holla2040/hyatt/README.md

# hyatt
A CNC wood router based on OpenBuilds WorkBee 1010, [Cypress PSoC 5LP CY8CKIT-059](http://www.cypress.com/documentation/development-kitsboards/cy8ckit-059-psoc-5lp-prototyping-kit-onboard-programmer-and) and [PSoC GRBL](https://github.com/bdring/Grbl_USB_Native). 

Hyatt Feature Set
* CY8KIT-059 based design
* 4 axis CNC controller, Dring GRBL port - PSoC HW pulse generation, debounce, interrupts
* Spindle speed/direction control - PSoC PWM
* Piezo element work piece probe - PSoC opamp, ADC, DAC comparator, interrupt
* Motor drive current monitor - PSoC analog mux and ADC
* Supply voltage monitor - PSoC ADC
* WiFi link with webserver, OTA, flash filesystem, websockets, TCP-serial bridge using ESP8266 - PSoC USART

Operator Interface
* 12 illuminated buttons via I2C I/O port expanders - PSoC I2C Fixed master
* Jog wheel with quad encoder - PSoC quad decoder
* 20x4 LCD panel display - PSoC I2C Fixed master
* 3.5" TFT 480x320 resistive touch screen display, attached to X axis gantry - PSoC USART
* Real-time feed speed override - PSoC ADC
* SDCard reader- PSoC SPI EmFile library
* Wireless CNC pendant - DirecTV remote control - my custom IR decoder using PSoC digital logic

[Hyatt Openbeam Workbee 1010 Settings](settings.txt)

PCB board, 100x100mm 2 layer, mixed through and smt parts

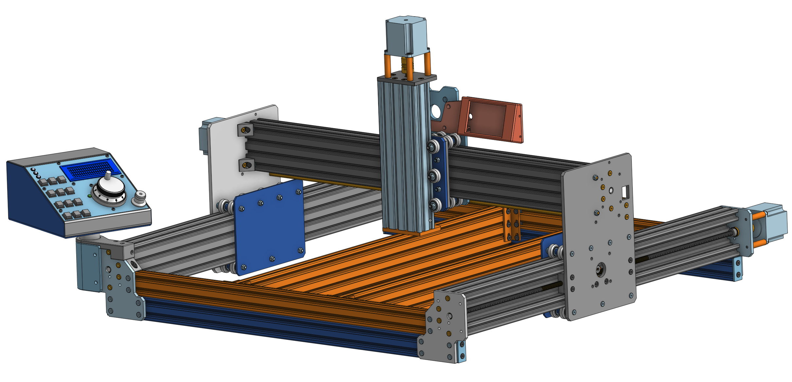
[picture p1: images/workbee-hyatt.png]
WorkBee


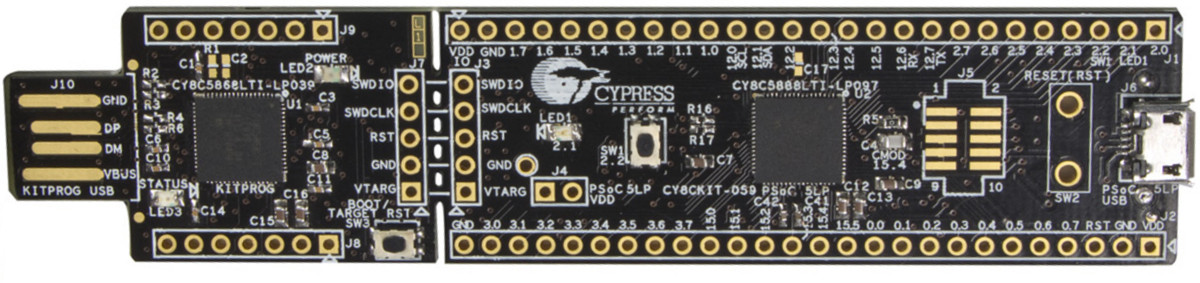
[picture p2: images/cy8ckit-059.jpg]
cy8ckit


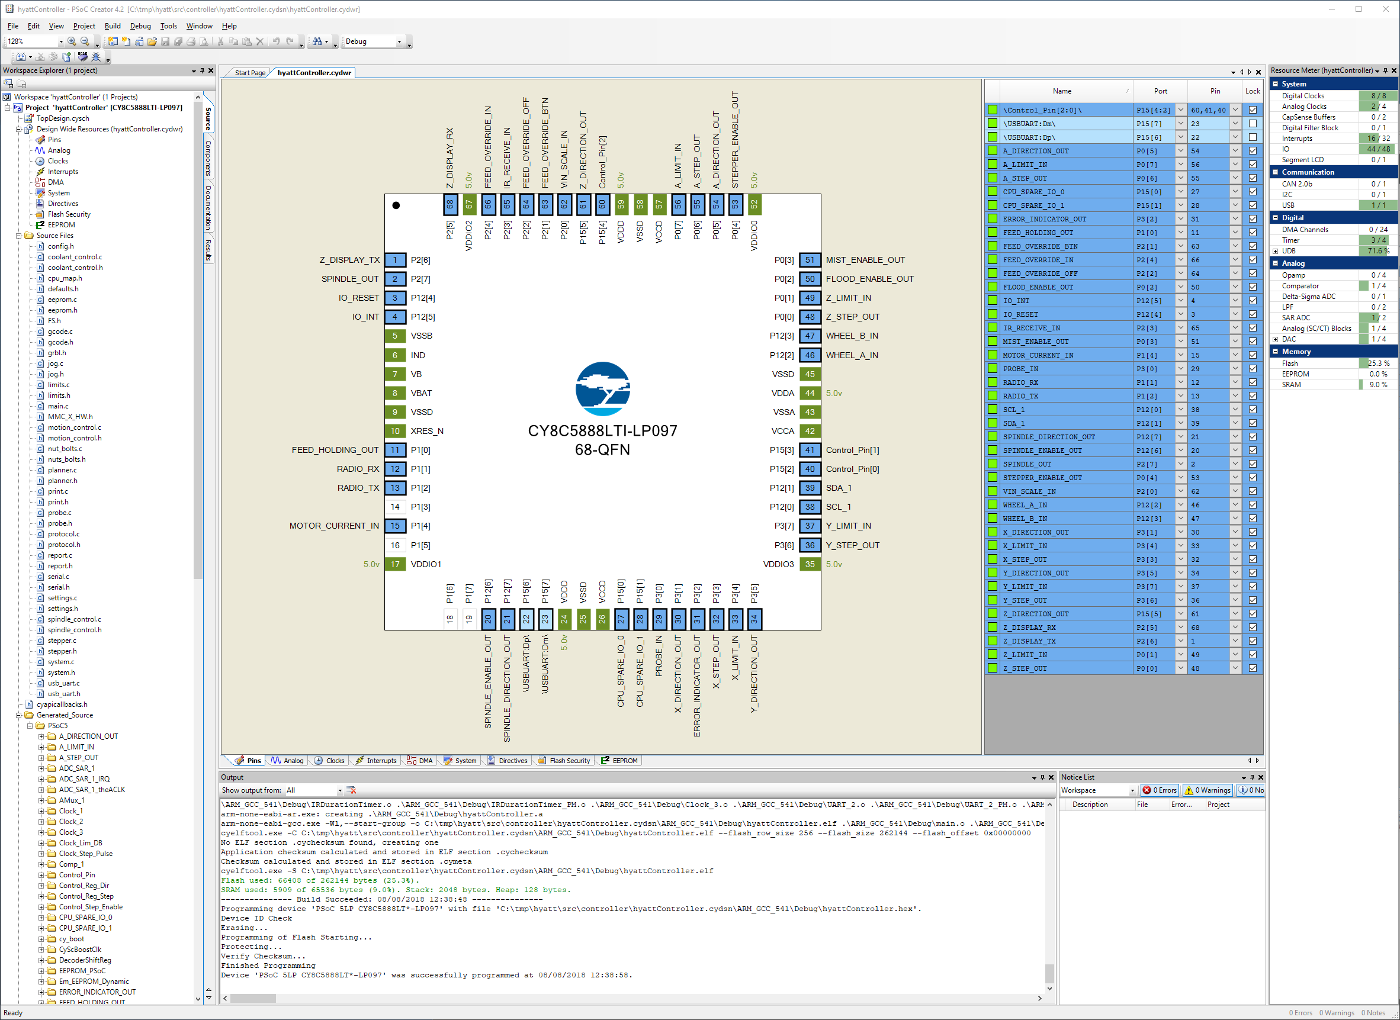
[picture p3: images/psoc5pins.png]
pins


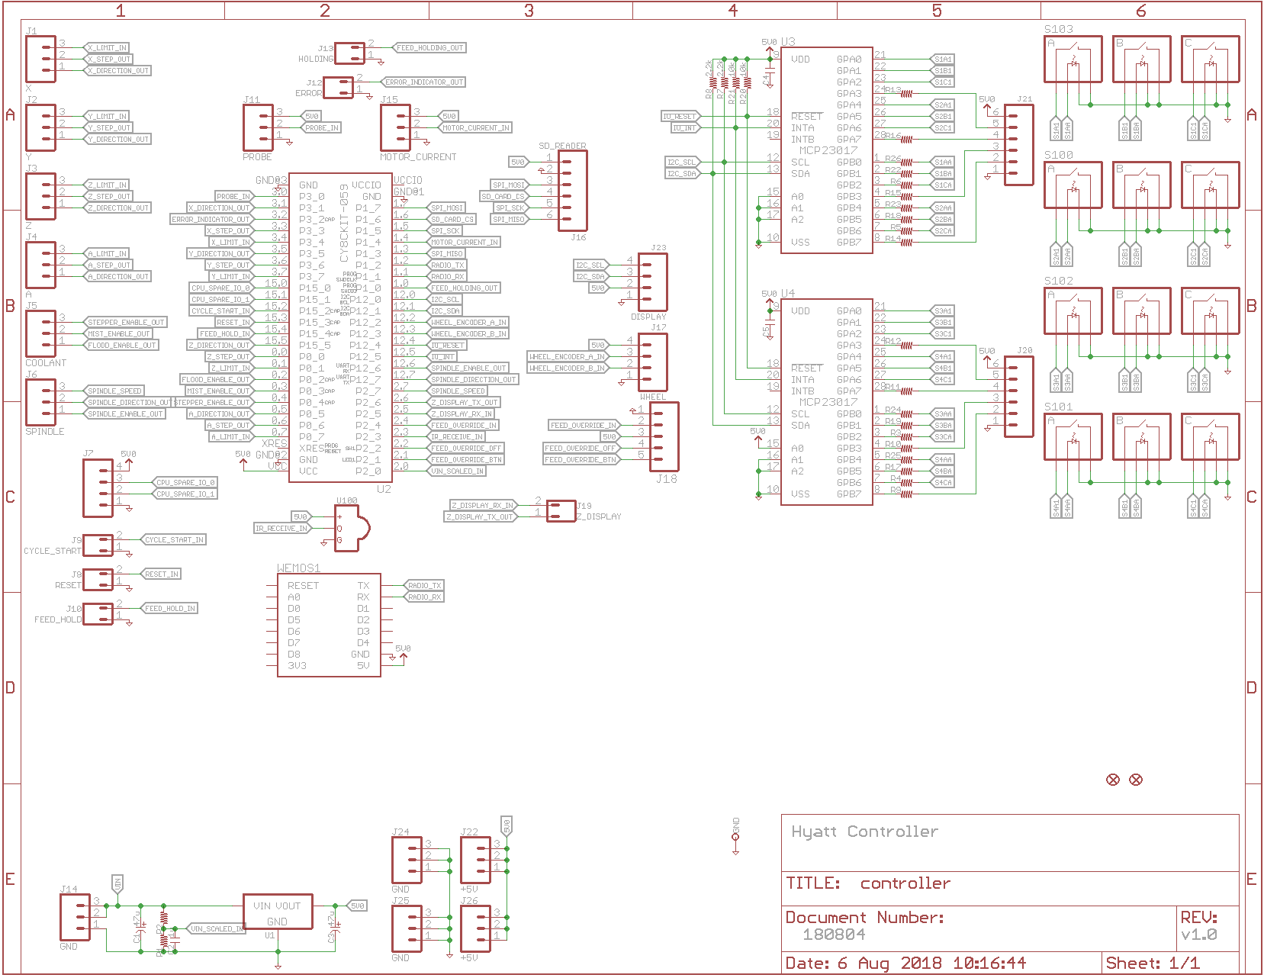
[picture p4: images/schematic.png]
schematic


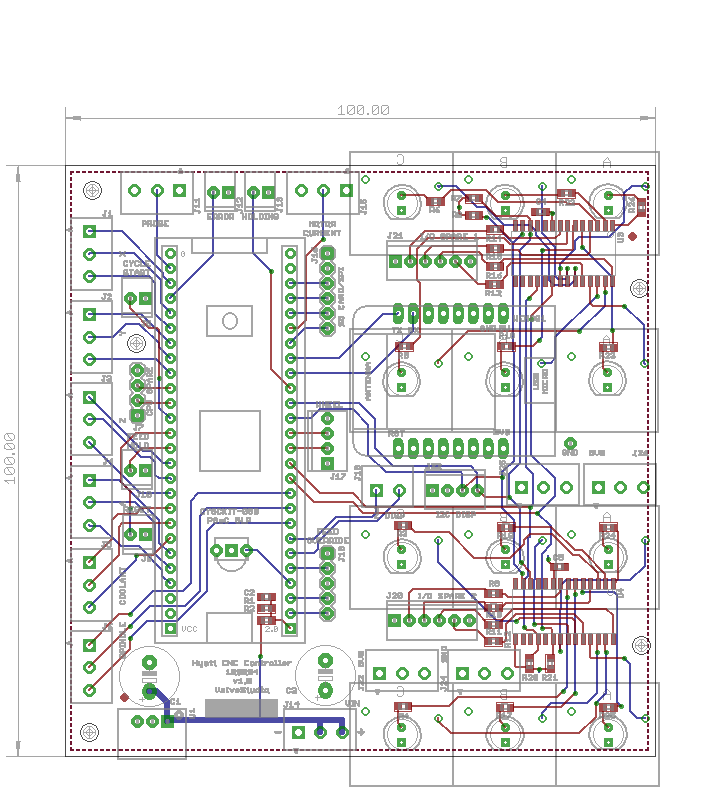
[picture p5: images/board.png]
board


---

Getting boards from [JLCPCB](https://jlcpcb.com/), $2 for 10 boards + $18 DHL US shipping.

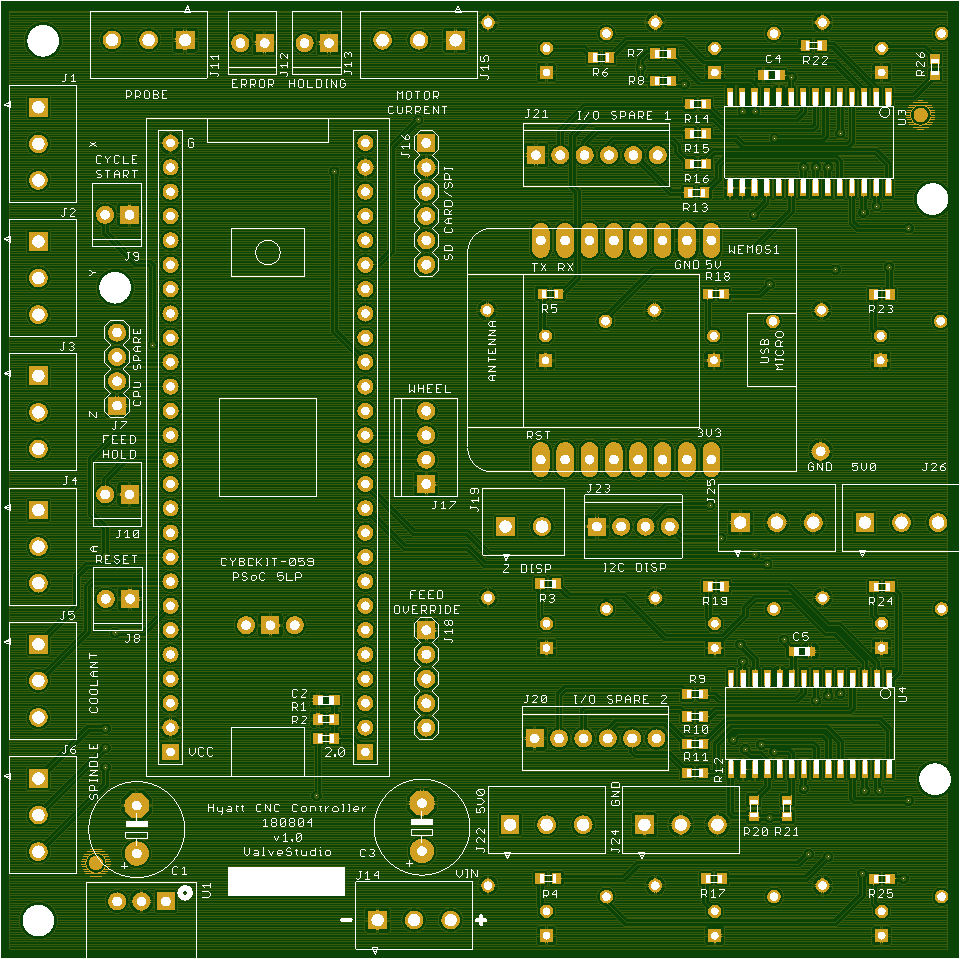
[picture p6: images/hyatt-PCB-component-v1.0-180804.png]
PCB Component Side


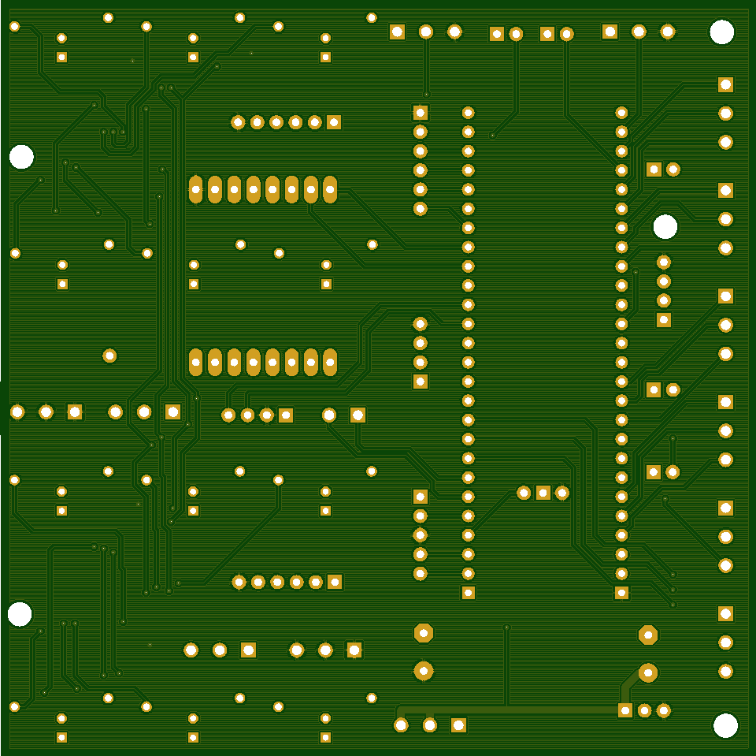
[picture p7: images/hyatt-PCB-solder-v1.0-180804.png]
PCB Solder Side


---

Watch the video (https://youtu.be/vaoxWDlP-cQ)

[Watch more hyatt videos](https://www.youtube.com/user/holla2040/search?query=hyatt)

---

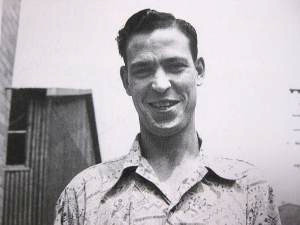
[picture p8: images/DaleHyatt.jpg]
Dale Hyatt


Project named after Dale Hyatt, the one of the original K&F guitar amp cabinet makers. See "[The Sound Heard 'Round the World](https://www.halleonardbooks.com/product/viewproduct.action?itemid=332779 "Fender - The Sound Heard 'Round the World")", Richard Smith, p28.
