holla2040/hyatt/src/controller/README.md

# hyatt controller
The hyatt controller software is based on Bart Dring's PSoC5 GRBL project, https://github.com/bdring/Grbl_USB_Native. Bart's project has GPL3 license, therefore my 'larger work' software additions also has this license.
