holla2040/hyatt/src/babysteps/cmm/centerOfCircle/circlePassingThrough3points.pdf

Circle passing through 3 points

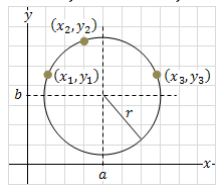
[picture p9: figure]

ambrsoft.com | Page 1 | R1.0

## AmBrSoft

–
