holla2040/hyatt/datasheets/Cypress - CY8C5888LTI-LP097.analog block.png

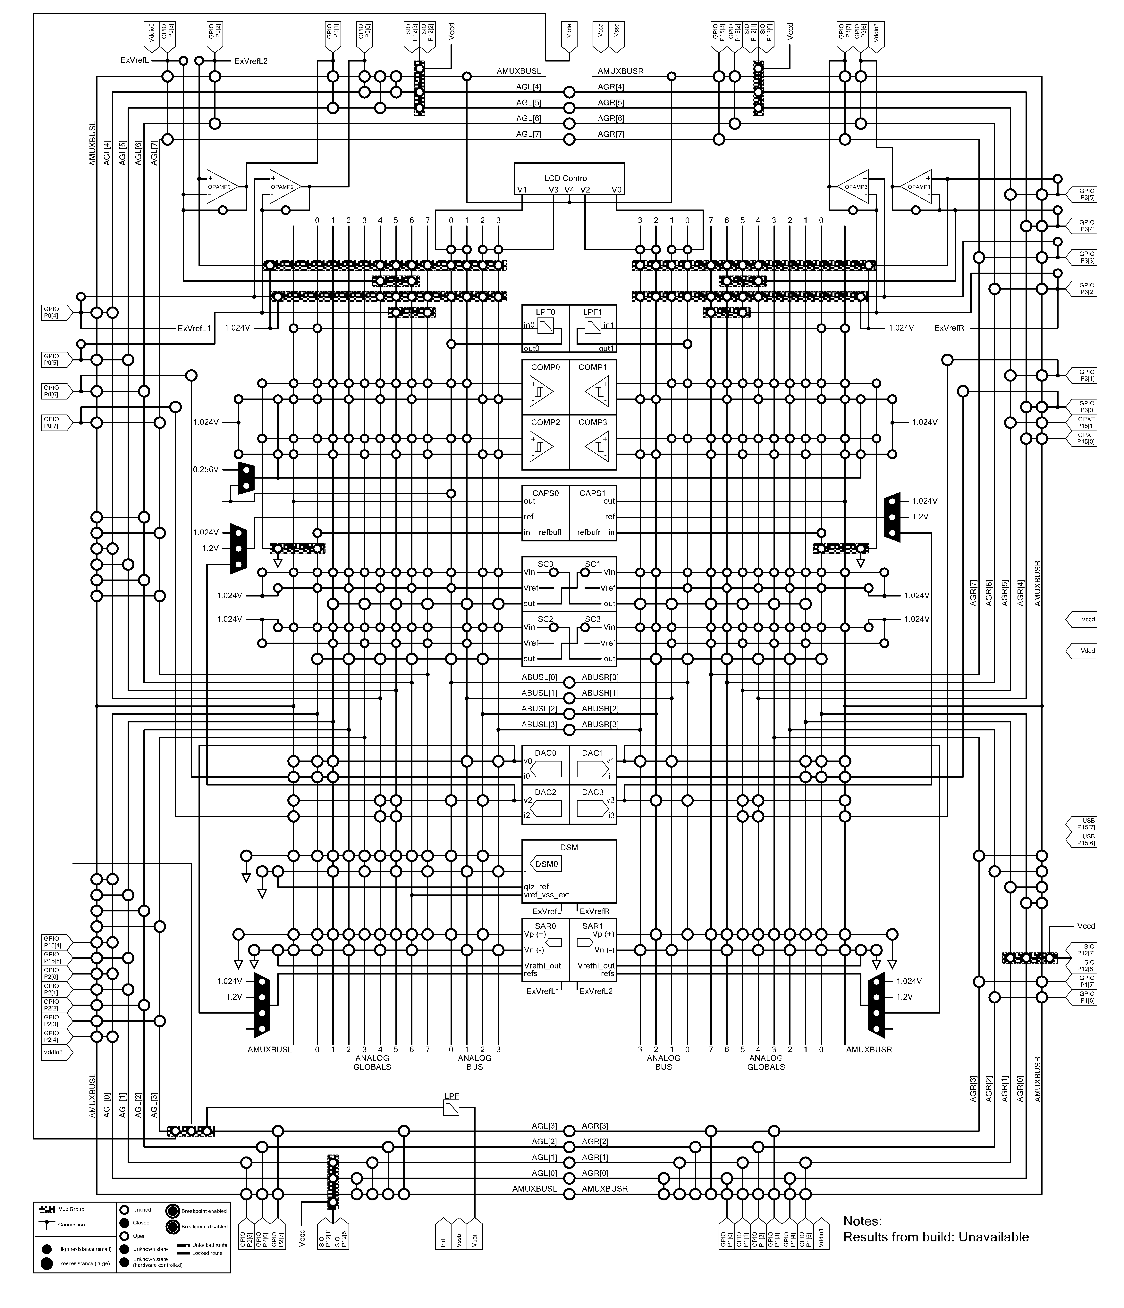
datasheets/Cypress - CY8C5888LTI-LP097.analog block.png
