holla2040/hyatt/datasheets/Cypress - CY8CKIT-059 Pin Details.png

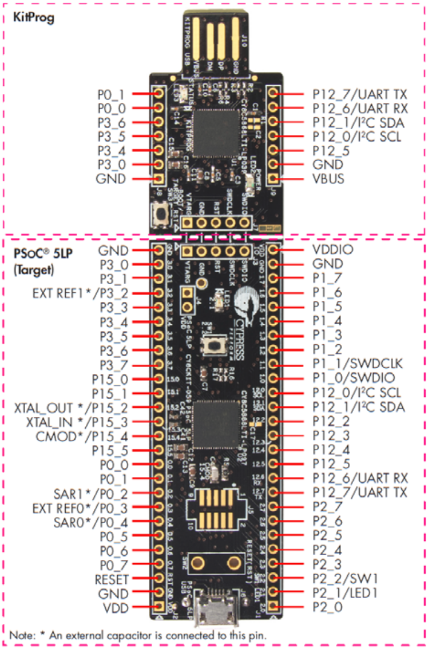
datasheets/Cypress - CY8CKIT-059 Pin Details.png
