holla2040/hyatt/datasheets/spindle/RT0700 Halter v9.png

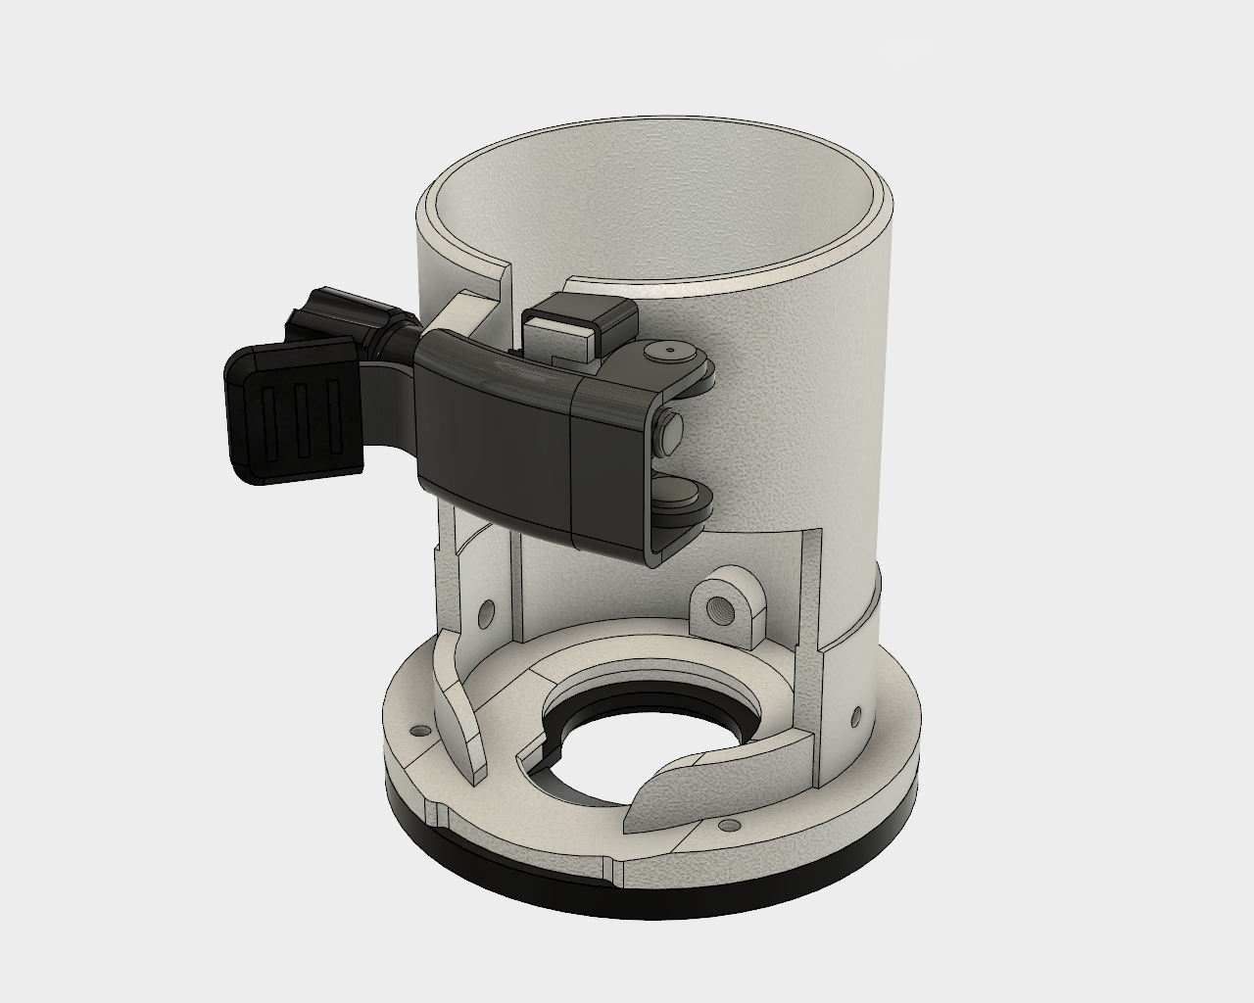
datasheets/spindle/RT0700 Halter v9.png
