holla2040/hyatt/datasheets/spindle/RT0700 im Halter v1.png

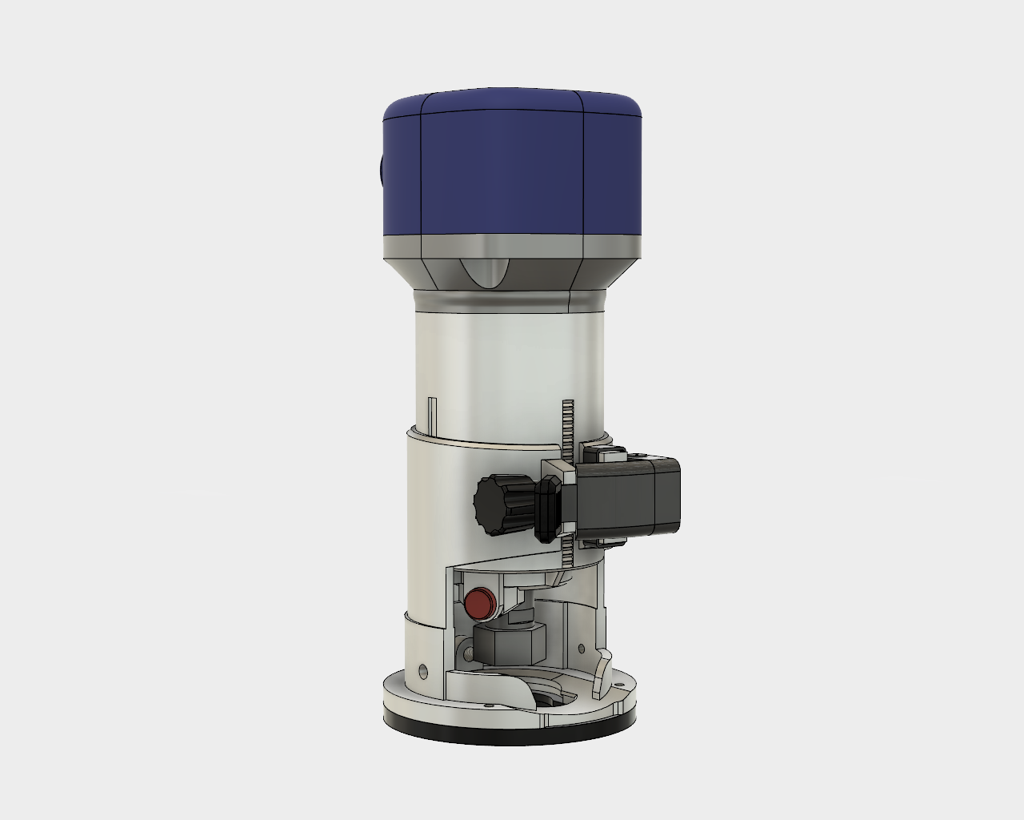
datasheets/spindle/RT0700 im Halter v1.png
