holla2040/hyatt/datasheets/spindle/RT0700 v10.png

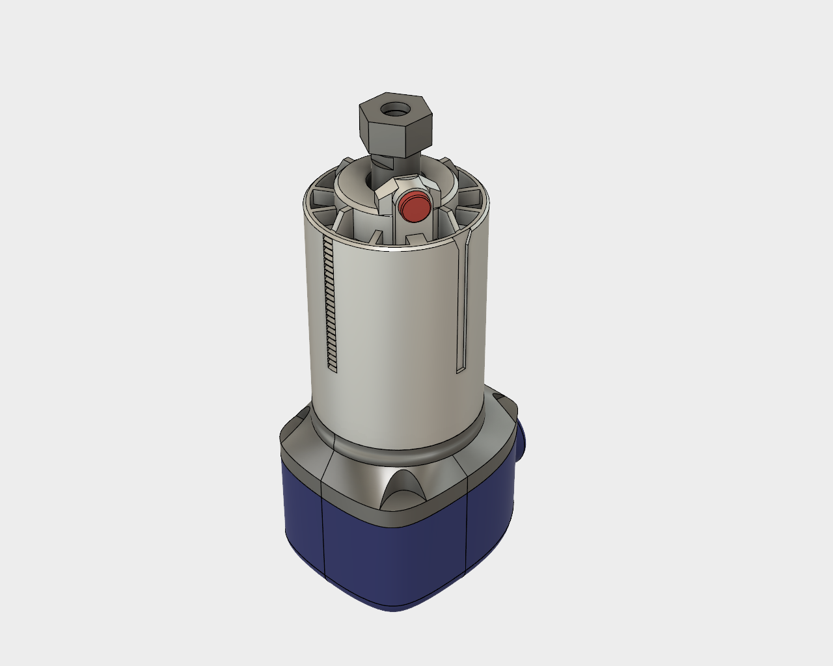
datasheets/spindle/RT0700 v10.png
