holla2040/hyatt/images/IR-mounting-1.jpg

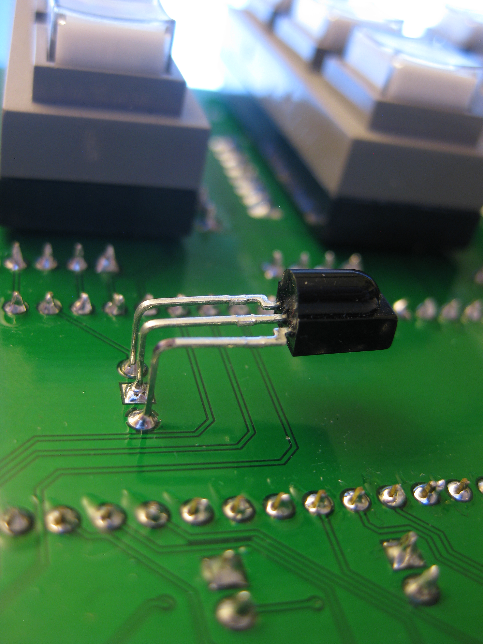
images/IR-mounting-1.jpg
