holla2040/hyatt/images/IR-mounting-2.jpg

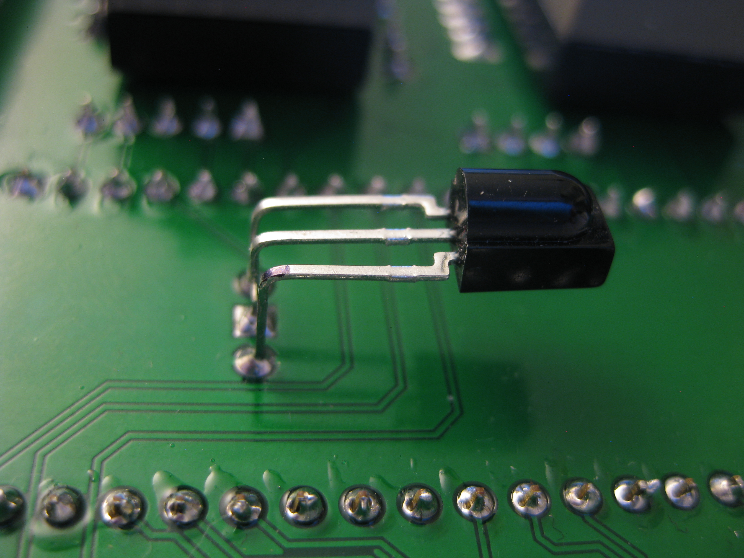
images/IR-mounting-2.jpg
