holla2040/hyatt/images/IR-mounting-3.jpg

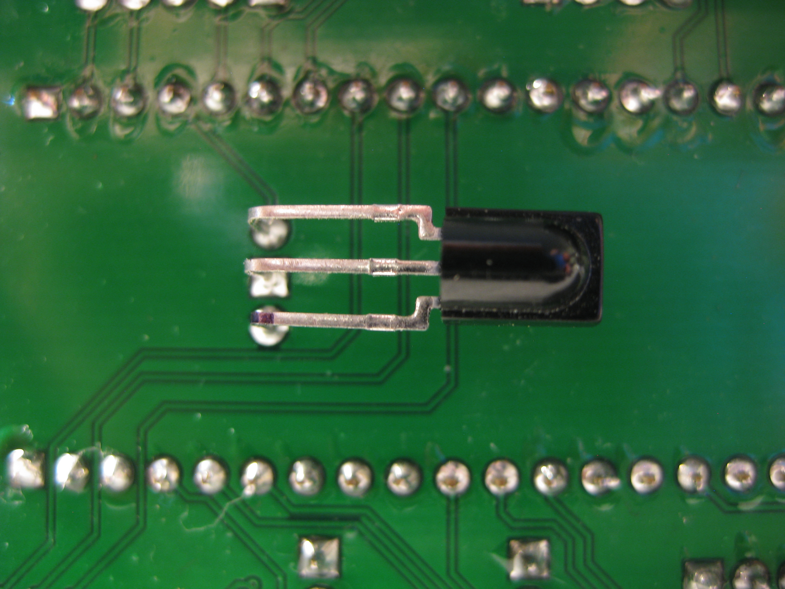
images/IR-mounting-3.jpg
