holla2040/hyatt/images/laserDriverTTL.jpg

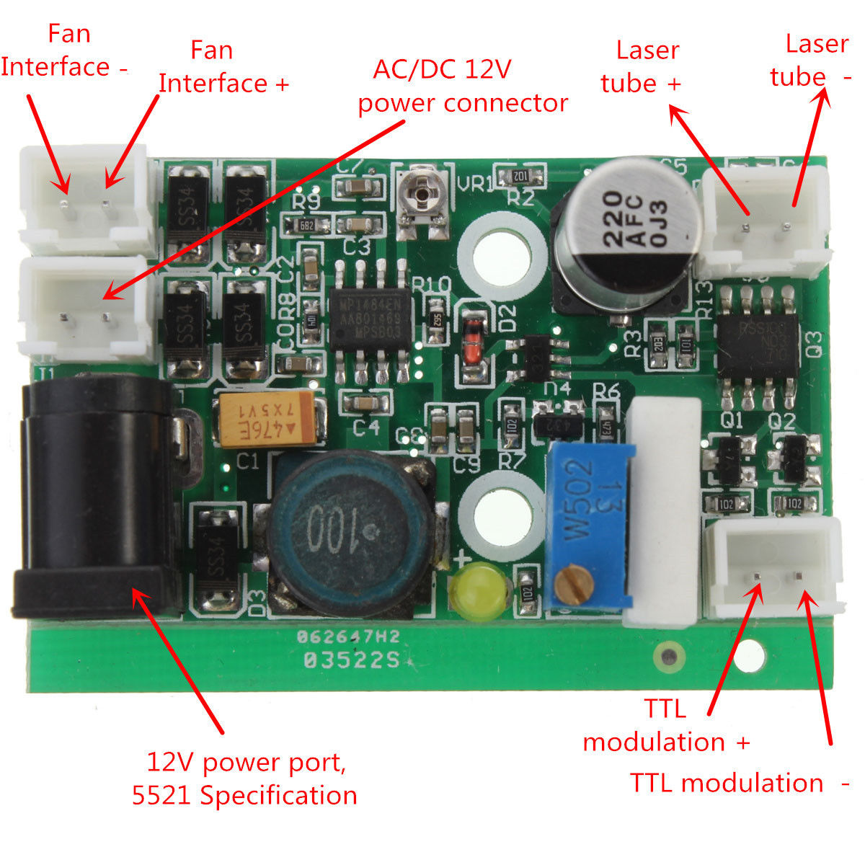
images/laserDriverTTL.jpg
