holla2040/hyatt/images/psocGRBL utilization.png

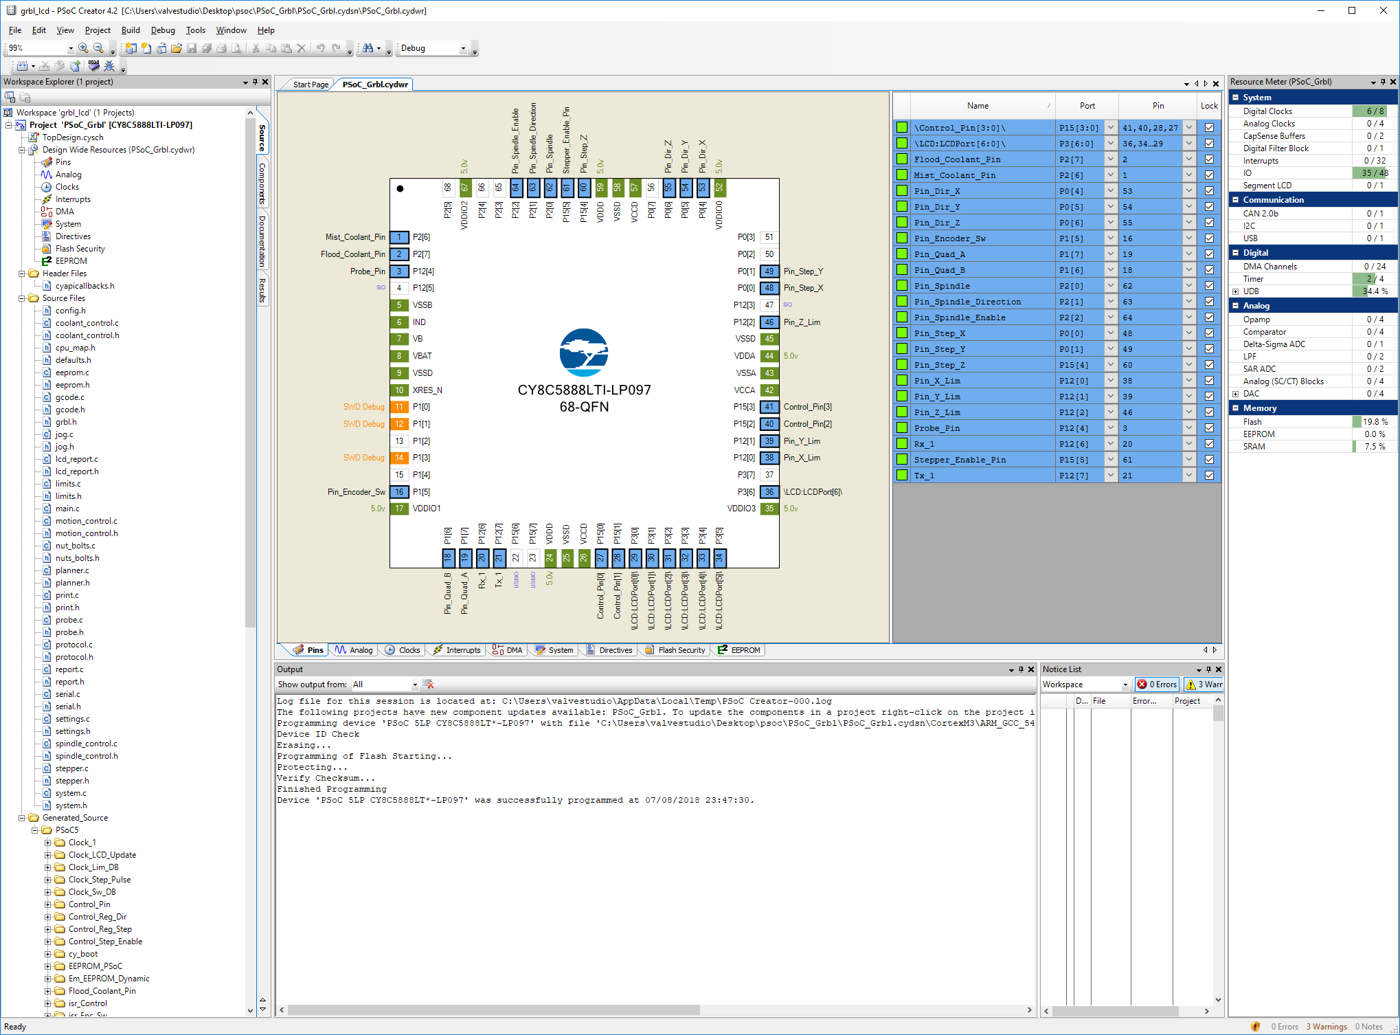
images/psocGRBL utilization.png
