holla2040/hyatt/images/rc65x.jpg

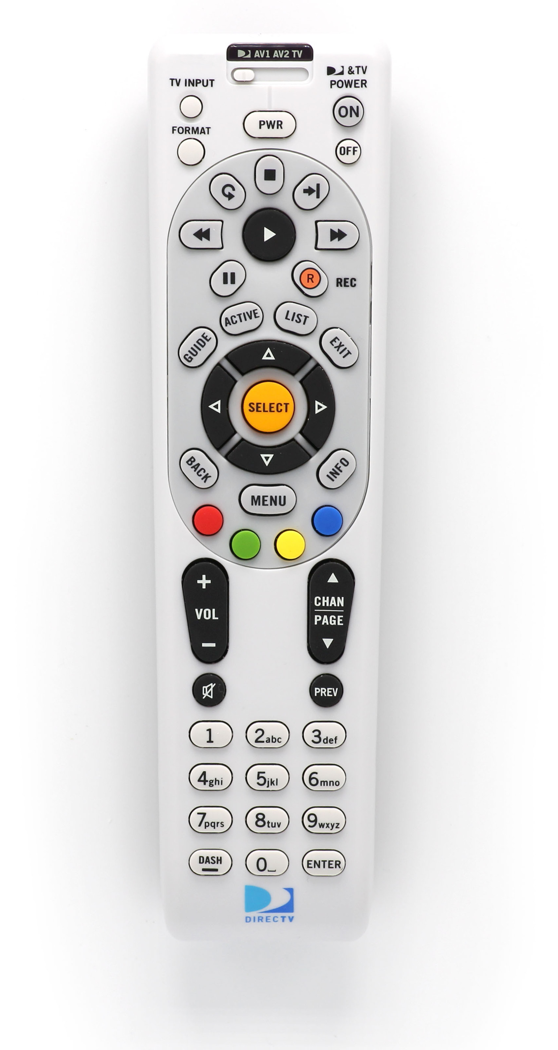
images/rc65x.jpg
