holla2040/hyatt/images/workbee-cnc.jpg

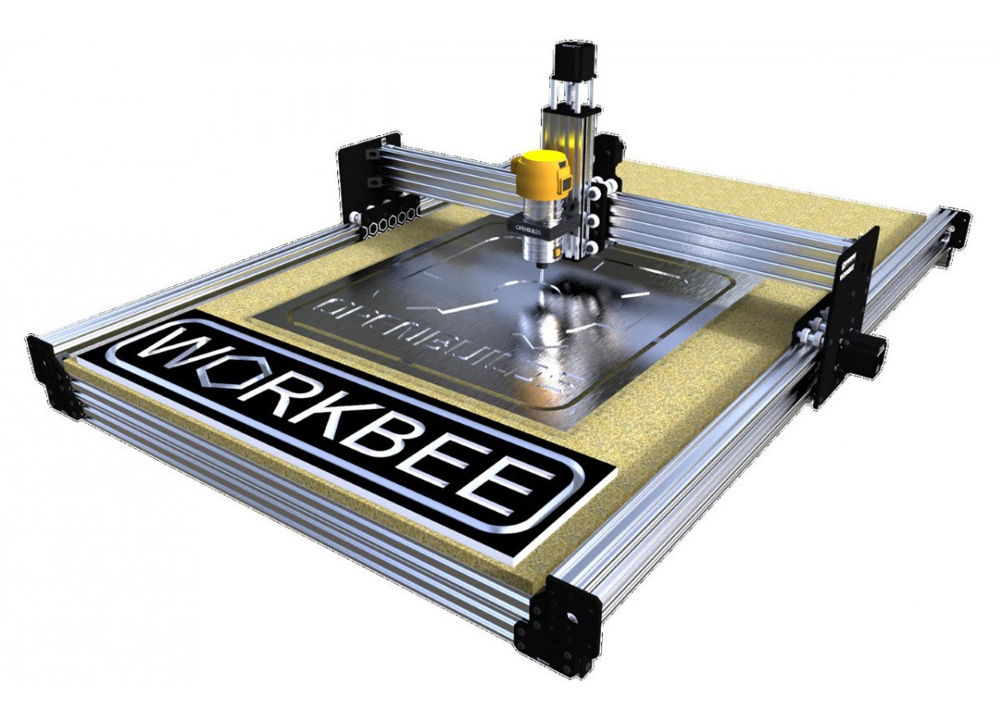
images/workbee-cnc.jpg
