holla2040/hyatt/release/v1.0-1.1 Modifications.jpg

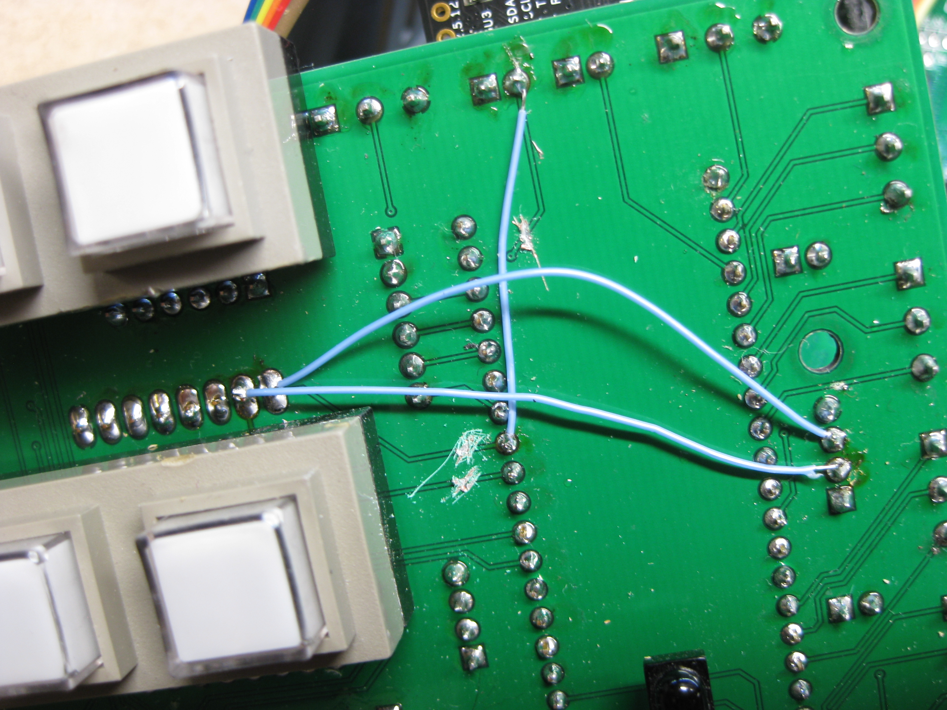
release/v1.0-1.1 Modifications.jpg
