holla2040/hyatt/hyatt bom.md

## Hyatt BOM
| Item | Quantity | Description | Manufacturer | MPN | Supplier | Supplier URL |
|:-----|:---|:---|:---|:---|:---|:---|
| 1 | 1 | OpenBuilds Workbee 1010 (40" x 40") | Openbuilds | 2410-Bundle | Openbuilds | https://openbuildspartstore.com/openbuilds-workbee-1010-40-x-40/ |
| 2 | 4 | Integrated Stepper Motor NEMA23 2NM | Just Motion Control | iHSS57-36-20 | Just Motion Control | http://www.jmc-driver.com/h-pd-213.html |
| 3 | 2 | 18mm x 37mm Semi Closed Cable Drag Chain | uxcell | a16072900ux0346 | Amazon | https://smile.amazon.com/gp/product/B01LZLU6AN |
| 4 | 3 | SPST Push Button Switch | Cylewet | CYT1092 | Amazon | https://smile.amazon.com/gp/product/B075VBWFM6 |
| 5 | 5 | Micro Switch SPDT 250V 5A Hole Spacing:9.5mm | Urbest | X001HYWYX5 | Amazon | https://www.amazon.com/gp/product/B074553YB3 |
| 6 | 1 | 1-1/4 HP Compact Router | Makita | RT0701C | Rockler | https://www.rockler.com/makita-rt0701c-1-1-4-hp-compact-router |
| 7 | 1 | 4 Pin SPST 4 Terminal ON-OFF 15A 250V | New Rise | E-TEN1221 | AliExpress | https://www.aliexpress.com/item/E-TEN1221-4-Pin-SPST-4-Terminal-ON-OFF-15A-250V-Toggle-Switch-TEN1221/32838059213.html |
| 8 | 4 | Dual Row Terminal Block Wire Connector 600V 15A | n/a | n/a | AliExpress | https://www.aliexpress.com/item/1-Pcs-Dual-Row-Barrier-Screw-Terminal-Block-Wire-Connector-600V-15A/32739170846.html |
| 9 | 1 | 4-Port USB Hub | D-Link | DUB-H4 | Amazon | https://www.amazon.com/gp/product/B00006B7DA |
| 10 | 4 | 8mm x 8mm Flexible Shaft Spider Motor Coupler | CNC-BZ | 100141-100141 | YellowVirtualSales  | https://www.ebay.com/itm/8mm-x-8mm-Flexible-Jaw-Coupler-CNC-Shaft-Spider-Stepper-Motor-Coupling-8x8/171182714194 |
| 11 | 1 | Spindle/Router LED Light Ring | Openbuilds | 2225 | Openbuilds | https://openbuildspartstore.com/spindle-router-led-light-ring/ |
| 12 | 1 | 36V 9.7A  350 Watt Ul Switching Power Supply | Mean Well | FBA_4330929540 | Amazon | https://www.amazon.com/NES-350-36-Switching-Power-Supply-110-240/dp/B01AWQ0Y52 |
| 13 | 6 | 3D Printed Brackets/Adapters | Hollabaugh | n/a | Hollabaugh | https://cad.onshape.com/documents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 |
| 14 | 1 | 14 Gal. 6.0-Peak HP Wet Dry Vac with Auto Detail Kit | Ridgid | WD1450 | Home Depot | https://www.homedepot.com/p/RIDGID-14-Gal-6-0-Peak-HP-Wet-Dry-Vac-with-Auto-Detail-Kit-WD1451/203820088 |
| 15 | 1 | PSoC 5LP Prototyping Kit | Cypress | CY8CKIT-059 | Cypress | http://www.cypress.com/documentation/development-kitsboards/cy8ckit-059-psoc-5lp-prototyping-kit-onboard-programmer-and |
| 16 | 1 | Interface Board | Hollabaugh | hyattPSoC5 | Hollabaugh | https://github.com/holla2040/hyatt |
| 17 | 1 | 60mm Hand Wheel 100PPR | n/a | n/a | Banggood | https://www.banggood.com/60mm-Pulser-Handwheel-Handle-Kit-5V-Manual-Pulse-Generator-CNC-Machine-Rotary-Encoder-Handwheel-p-1084181.html |
| 18 | 4 | Switch Matrix 3x1 Gray | Grayhill | 82-350-12 | Digikey | https://www.digikey.com/product-detail/en/grayhill-inc/82-350-12/82-350-12-ND/638161 |
| 19 | 1 | Feed Override | n/a | n/a | All Electronics | https://www.allelectronics.com/item/pws-104/100k-pot-with-switches-and-detents/1.html |
| 20 | 1 | 20x4 IIC/I2C/TWI LCD Module | n/a | n/a | Sain Smart | https://www.sainsmart.com/products/20x4-iic-i2c-twi-lcd-module |
| 21 | 1 | Nextion 3.5" HMI TFT LCD Touch Display Module | Itead | NX4832T035 | Itead | https://www.itead.cc/nextion-nx4832t035.html |
| 22 | 1 | Enclosure | n/a | n/a | n/a | n/a |
| 23 | 1 | Spindle power power relay | n/a | n/a | Banggood | https://www.banggood.com/2-Way-Relay-Module-With-Optocoupler-Protection-p-972428.html |
| 24 | 3 | Rockler Vacuum Clamp Pod Kit | Rockler | 53418 | Rockler | https://www.rockler.com/rockler-vacuum-clamp-pod-kit |
| 25 | 1 | Arduino SD Card Module Slot Socket Reader | n/a | n/a | Worldchips | https://www.aliexpress.com/item/5pcs-SD-Card-Module-Slot-Socket-Reader-For-Arduino-ARM-MCU-NEW/32649387869.html |
| 26 | 1 | IR Handheld Pendant | DirecTV | RC65 | Amazon | https://www.amazon.com/DIRECTV-Universal-Remote-Control-RC66RX/dp/B019WJROSK |
| 27 | 1 | WiFi Module | Wemos | D1 Mini | Banggood | https://www.banggood.com/Wemos-D1-Mini-V3_0_0-WIFI-Internet-Of-Things-Development-Board-Based-ESP8266-4MB-p-1264245.html |
| 28 | 1 | 2500mW Blue Laser Module With Heat Sink | ElekMaker | FB03-2500 | Banggood | https://www.banggood.com/EleksMaker-FB03-2500-2500mW-Blue-Laser-Module-2_54-3P-TTLPWM-Modulation-for-DIY-Laser-Engraver-p-1266171.html  |
| 29 | 1 | 0.01MM 0-10mm Dial Indicator | Vanpower | 7yr2qp2df8dd1-US01 | Amazon | https://www.amazon.com/gp/product/B0755D9K6J/ref=oh_aui_detailpage_o04_s00 |
| 30 | 1 | 0.01MM 0-10mm Dial Indicator | Danio | 4.01123e+07 | Banggood | https://www.banggood.com/DANIU-40112302-Dial-Test-Indicator-Precision-Metric-with-Dovetail-rails-p-1157267.html |
| 31 | 1 | 5V 30A ACS712 Range Current Sensor Module Board | n/a | n/a | Banggood | https://www.banggood.com/1PC-30A-New-Range-Current-Sensor-Module-for-ACS712-p-86583.html |
| 32 | 1 | Mist Coolant Lubrication Spray System For 8mm | n/a | n/a | Amazon | https://www.amazon.com/Coolant-Lubrication-Spray-System-Milling/dp/B01C74DL98 |
