holla2040/hyatt/datasheets/Makita-Router-Mount-Adaptor.stl

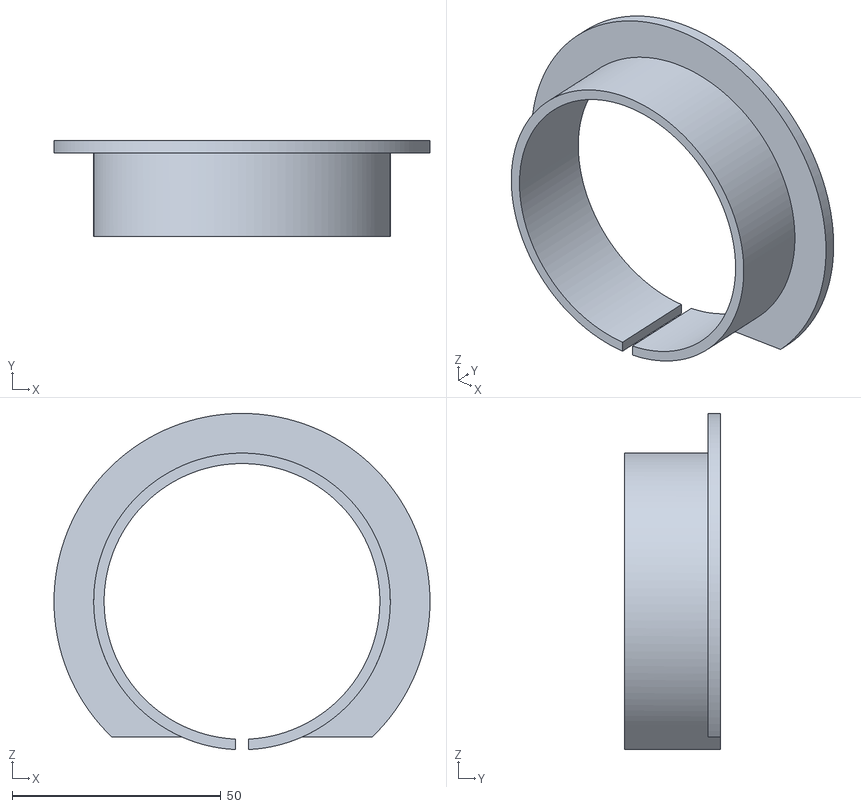
[picture p23: CAD file, 2019-03-07]
datasheets/Makita-Router-Mount-Adaptor.stl
90.0 x 23.0 x 80.5
