holla2040/hyatt/datasheets/spindle/RT0700 im Halter v1.step

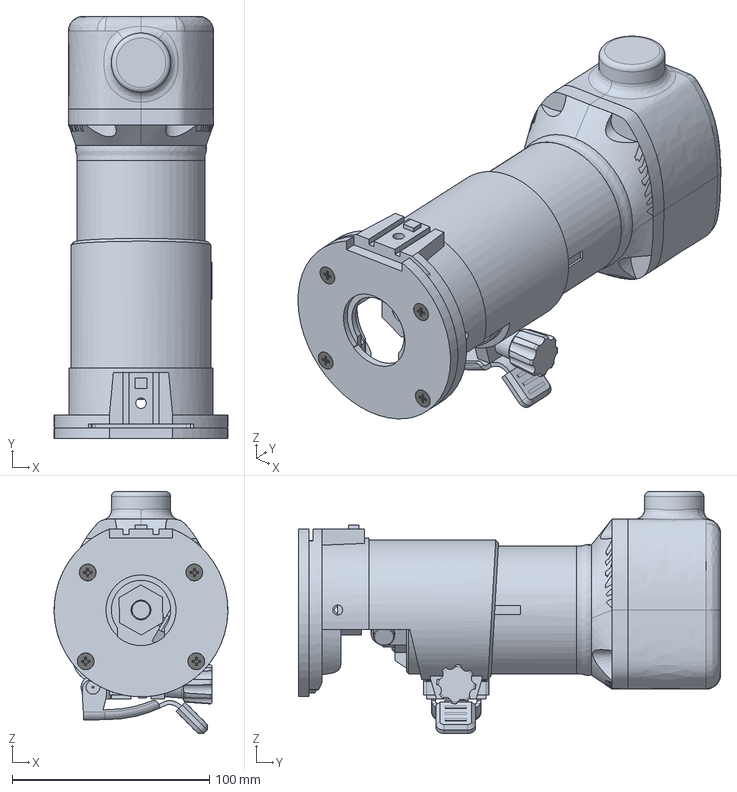
[picture p24: CAD file, 2018-08-04]
datasheets/spindle/RT0700 im Halter v1.step
88.0 x 213.9 x 122.6 mm
Aufnahme
Grundplatte
Reibblech
U-Bügel
Hebel
Drehknopf
Achse
Mutter
Niete x 2
Zahnrad
Senkkopf M4x10 v1 x 4
Gummi
