holla2040/hyatt/datasheets/spindle/RT0700 Halter v9.step

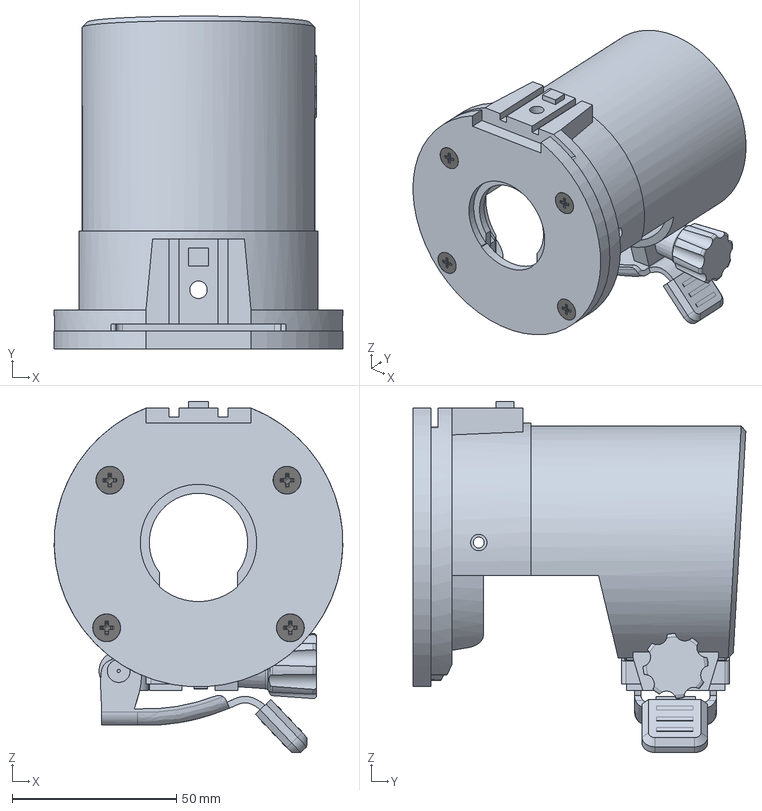
[picture p25: CAD file, 2018-08-04]
datasheets/spindle/RT0700 Halter v9.step
88.0 x 101.4 x 107.0 mm
Aufnahme
Grundplatte
Reibblech
U-Bügel
Hebel
Drehknopf
Achse
Mutter
Niete x 2
Zahnrad
Senkkopf M4x10 v1 x 4
Gummi
