holla2040/hyatt/datasheets/spindle/RT0700 v10.step

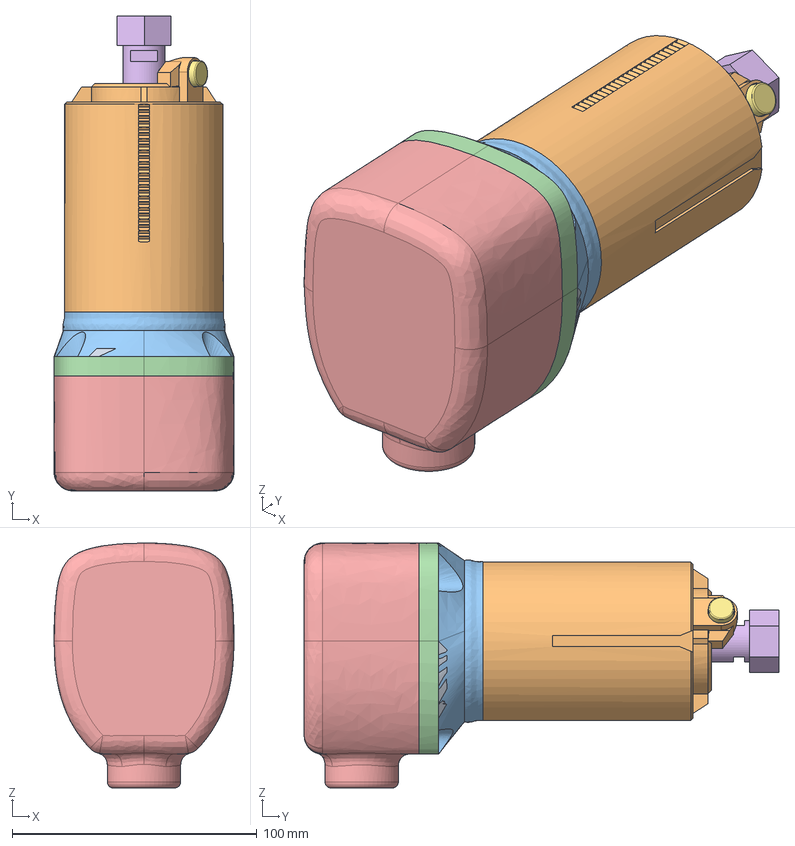
[picture p26: CAD file, 2018-08-04]
datasheets/spindle/RT0700 v10.step
73.5 x 194.0 x 100.1 mm
