holla2040/hyatt/(threads)

Thread 1 (2018-10-08):

hyatt loop fails if i2c devices are missing

holla2040, 2018-10-08:
desktop dev with just 059 (no hyatt circuit board), I2C operations fail.

holla2040, 2019-03-10:
i2c keypad and display are determined to exist at startup. then all the i2c comm is bit checked.

Closed 2019-03-10.
