holla2040/hyatt/design/workbee wire routing.pdf

yml | ymr

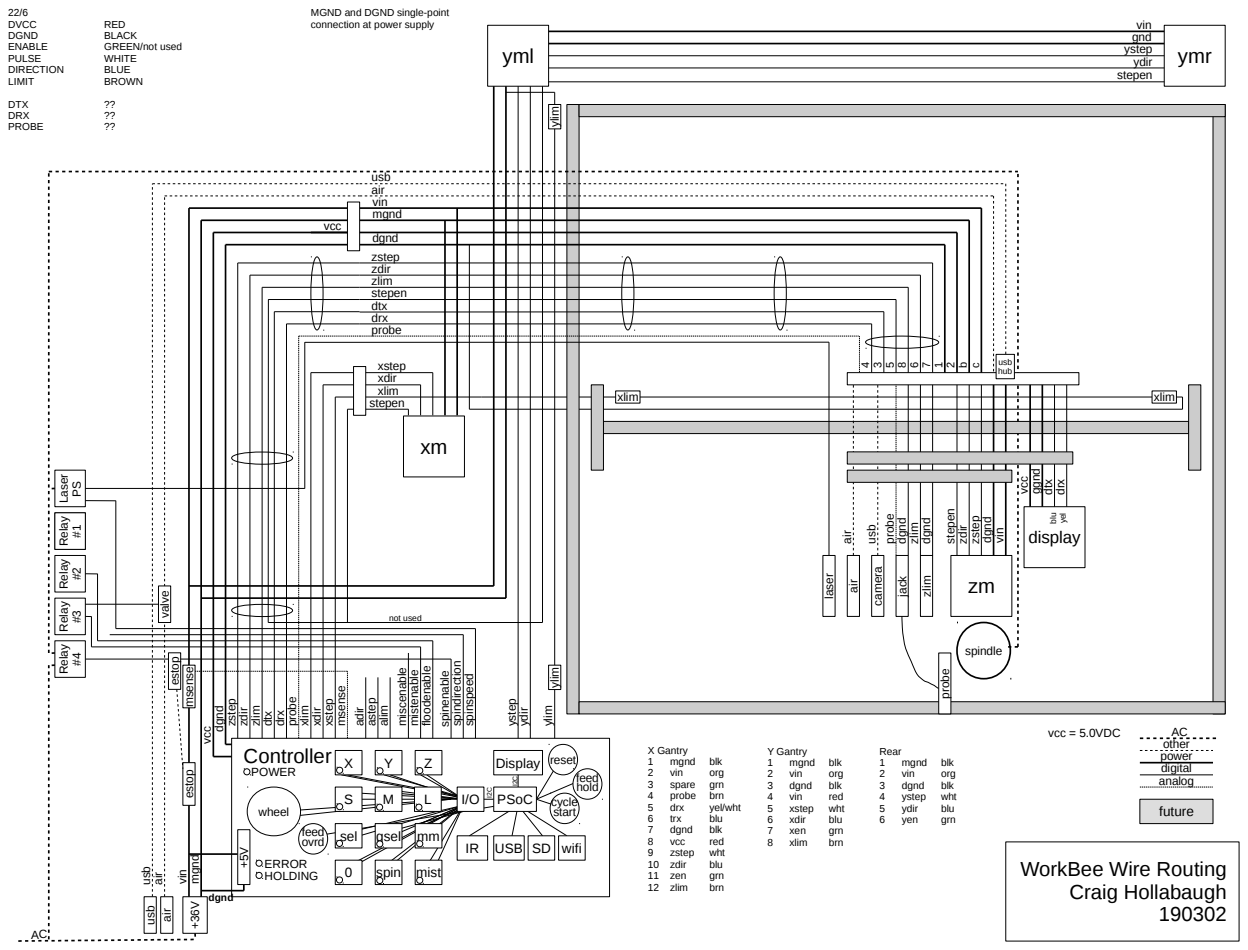
[picture p27: page 1]
Controller; ystep; ydir; vin gnd ystep ydir; adir; vcc; zdir; ylim; zlim; xstep; xdir; xlim; probe; dtx; drx; usb usb air; air; vin; mgnd; zm camera; ylim ylim; dgnd; zstep; stepen; display; ggnd; probe dgnd; usb; wheel; POWER; msense X Y Z; reset feed hold cycle start; USB; Display; other power digital analog; future; feed ovrd; estop msense; spindle; jack; wifi; astep; alim; spinenable; sel; gsel; spin; mist; miscenable; PSoC; ERROR HOLDING; vcc = 5.0VDC; estop; usb hub; blu; yel; DVCC; RED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

MGND and DGND single-point
connection at power supply

zdir
zlim
stepen
dtx
drx
probe

WorkBee Wire Routing
Craig Hollabaugh
