holla2040/hyatt/board/controller-sch.pdf

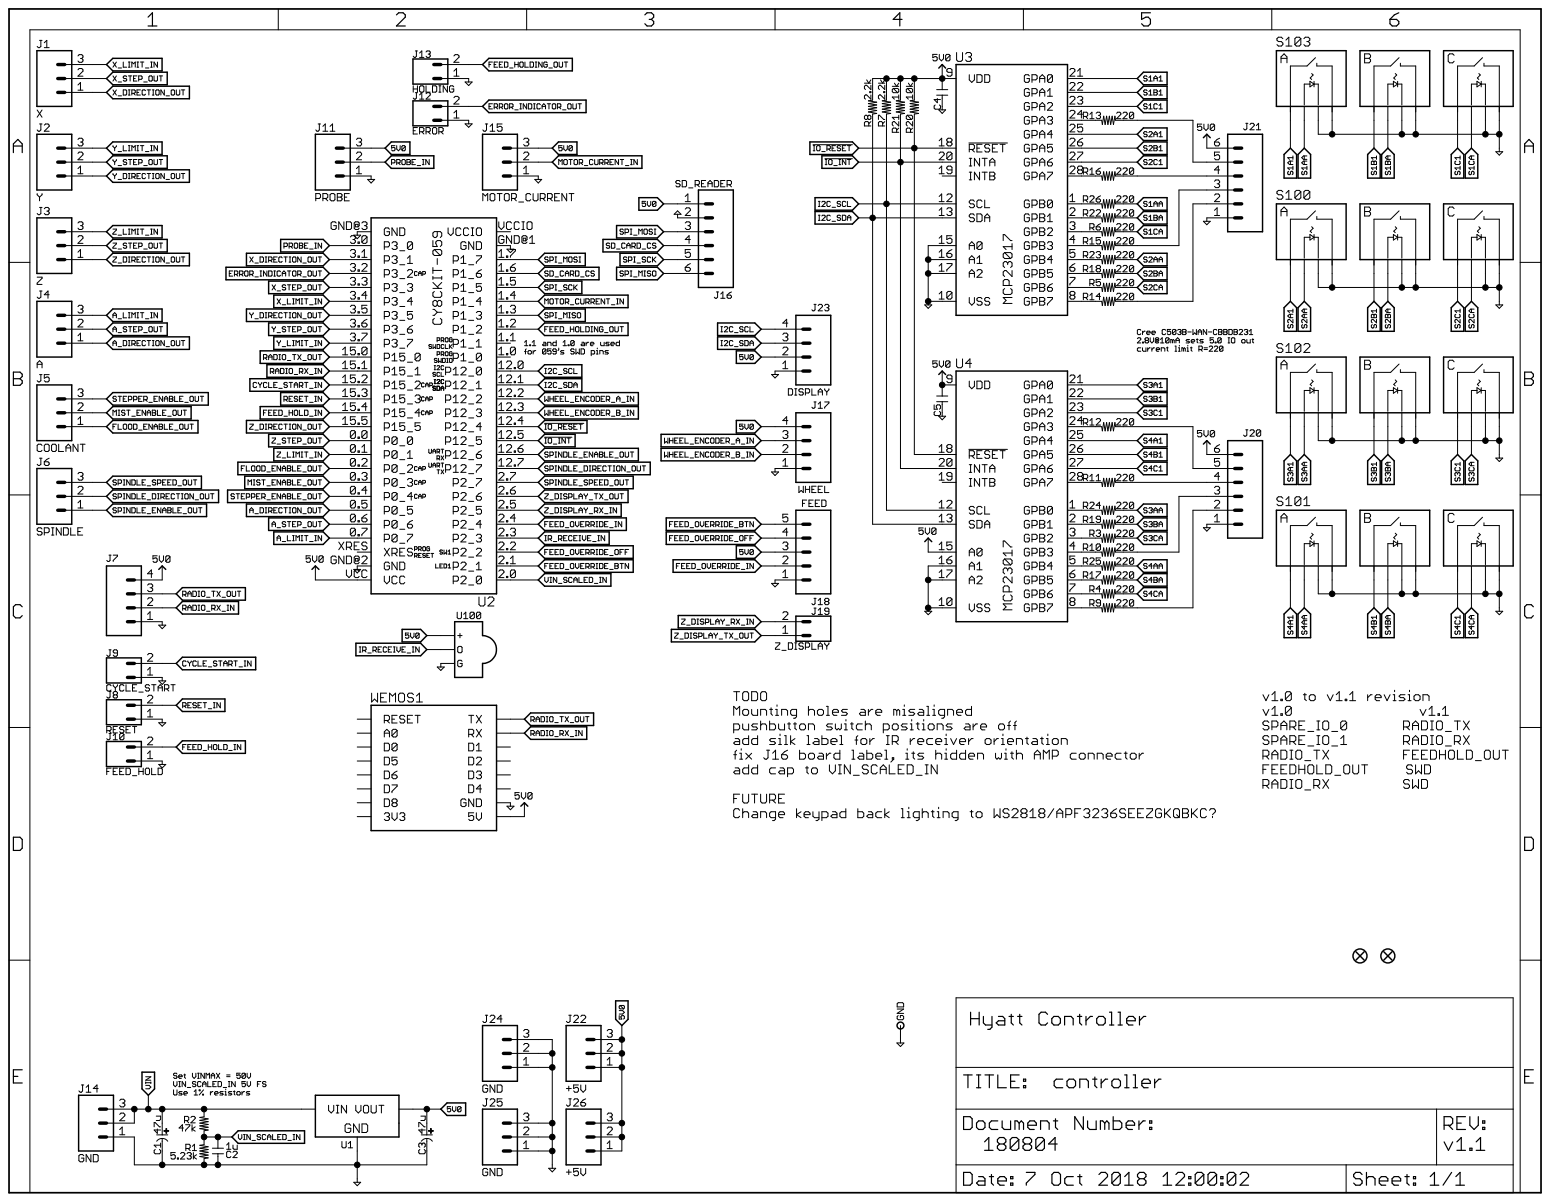
[picture p28: page 1]
