holla2040/hyatt/release/v1.0-180804/controller-brd.pdf

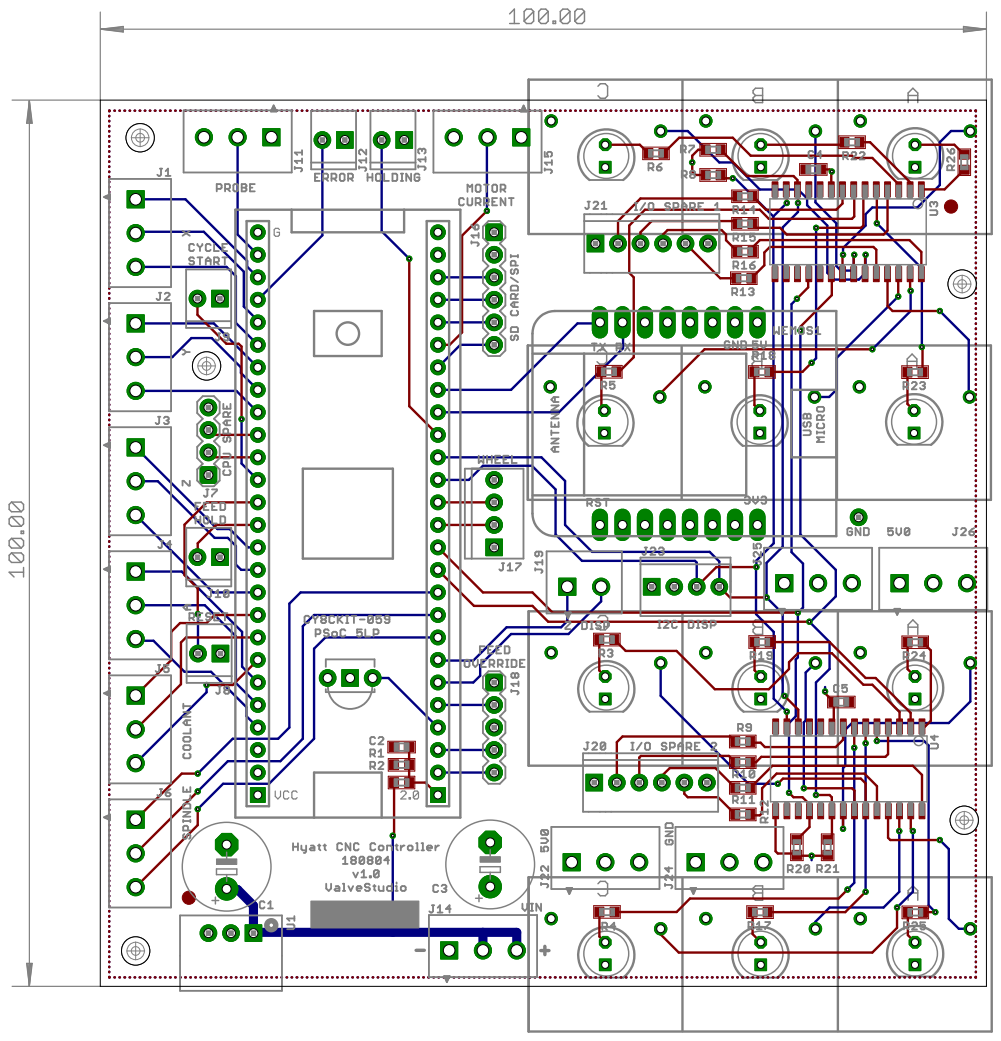
[picture p29: page 1]
