holla2040/hyatt/release/v1.0-180804/controller-sch.pdf

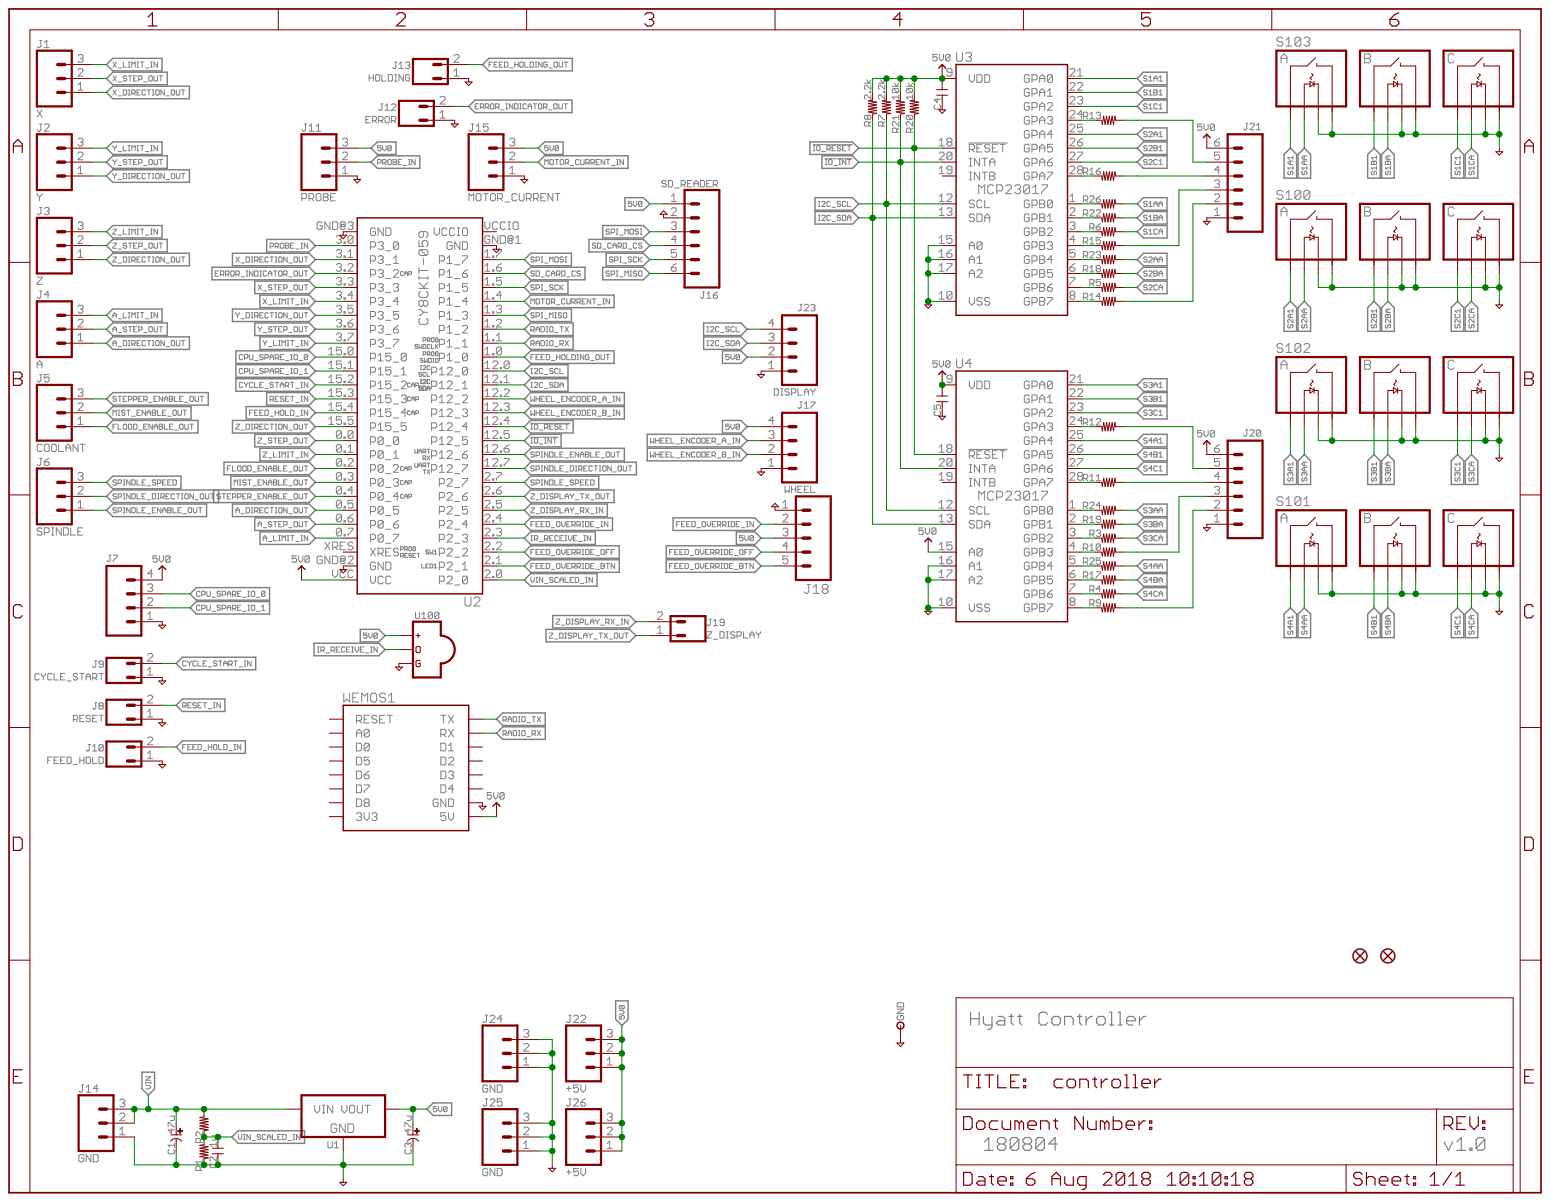
[picture p30: page 1]
