holla2040/hyatt/board/controller.brd

## EAGLE design board/controller.brd (2019-04-14)

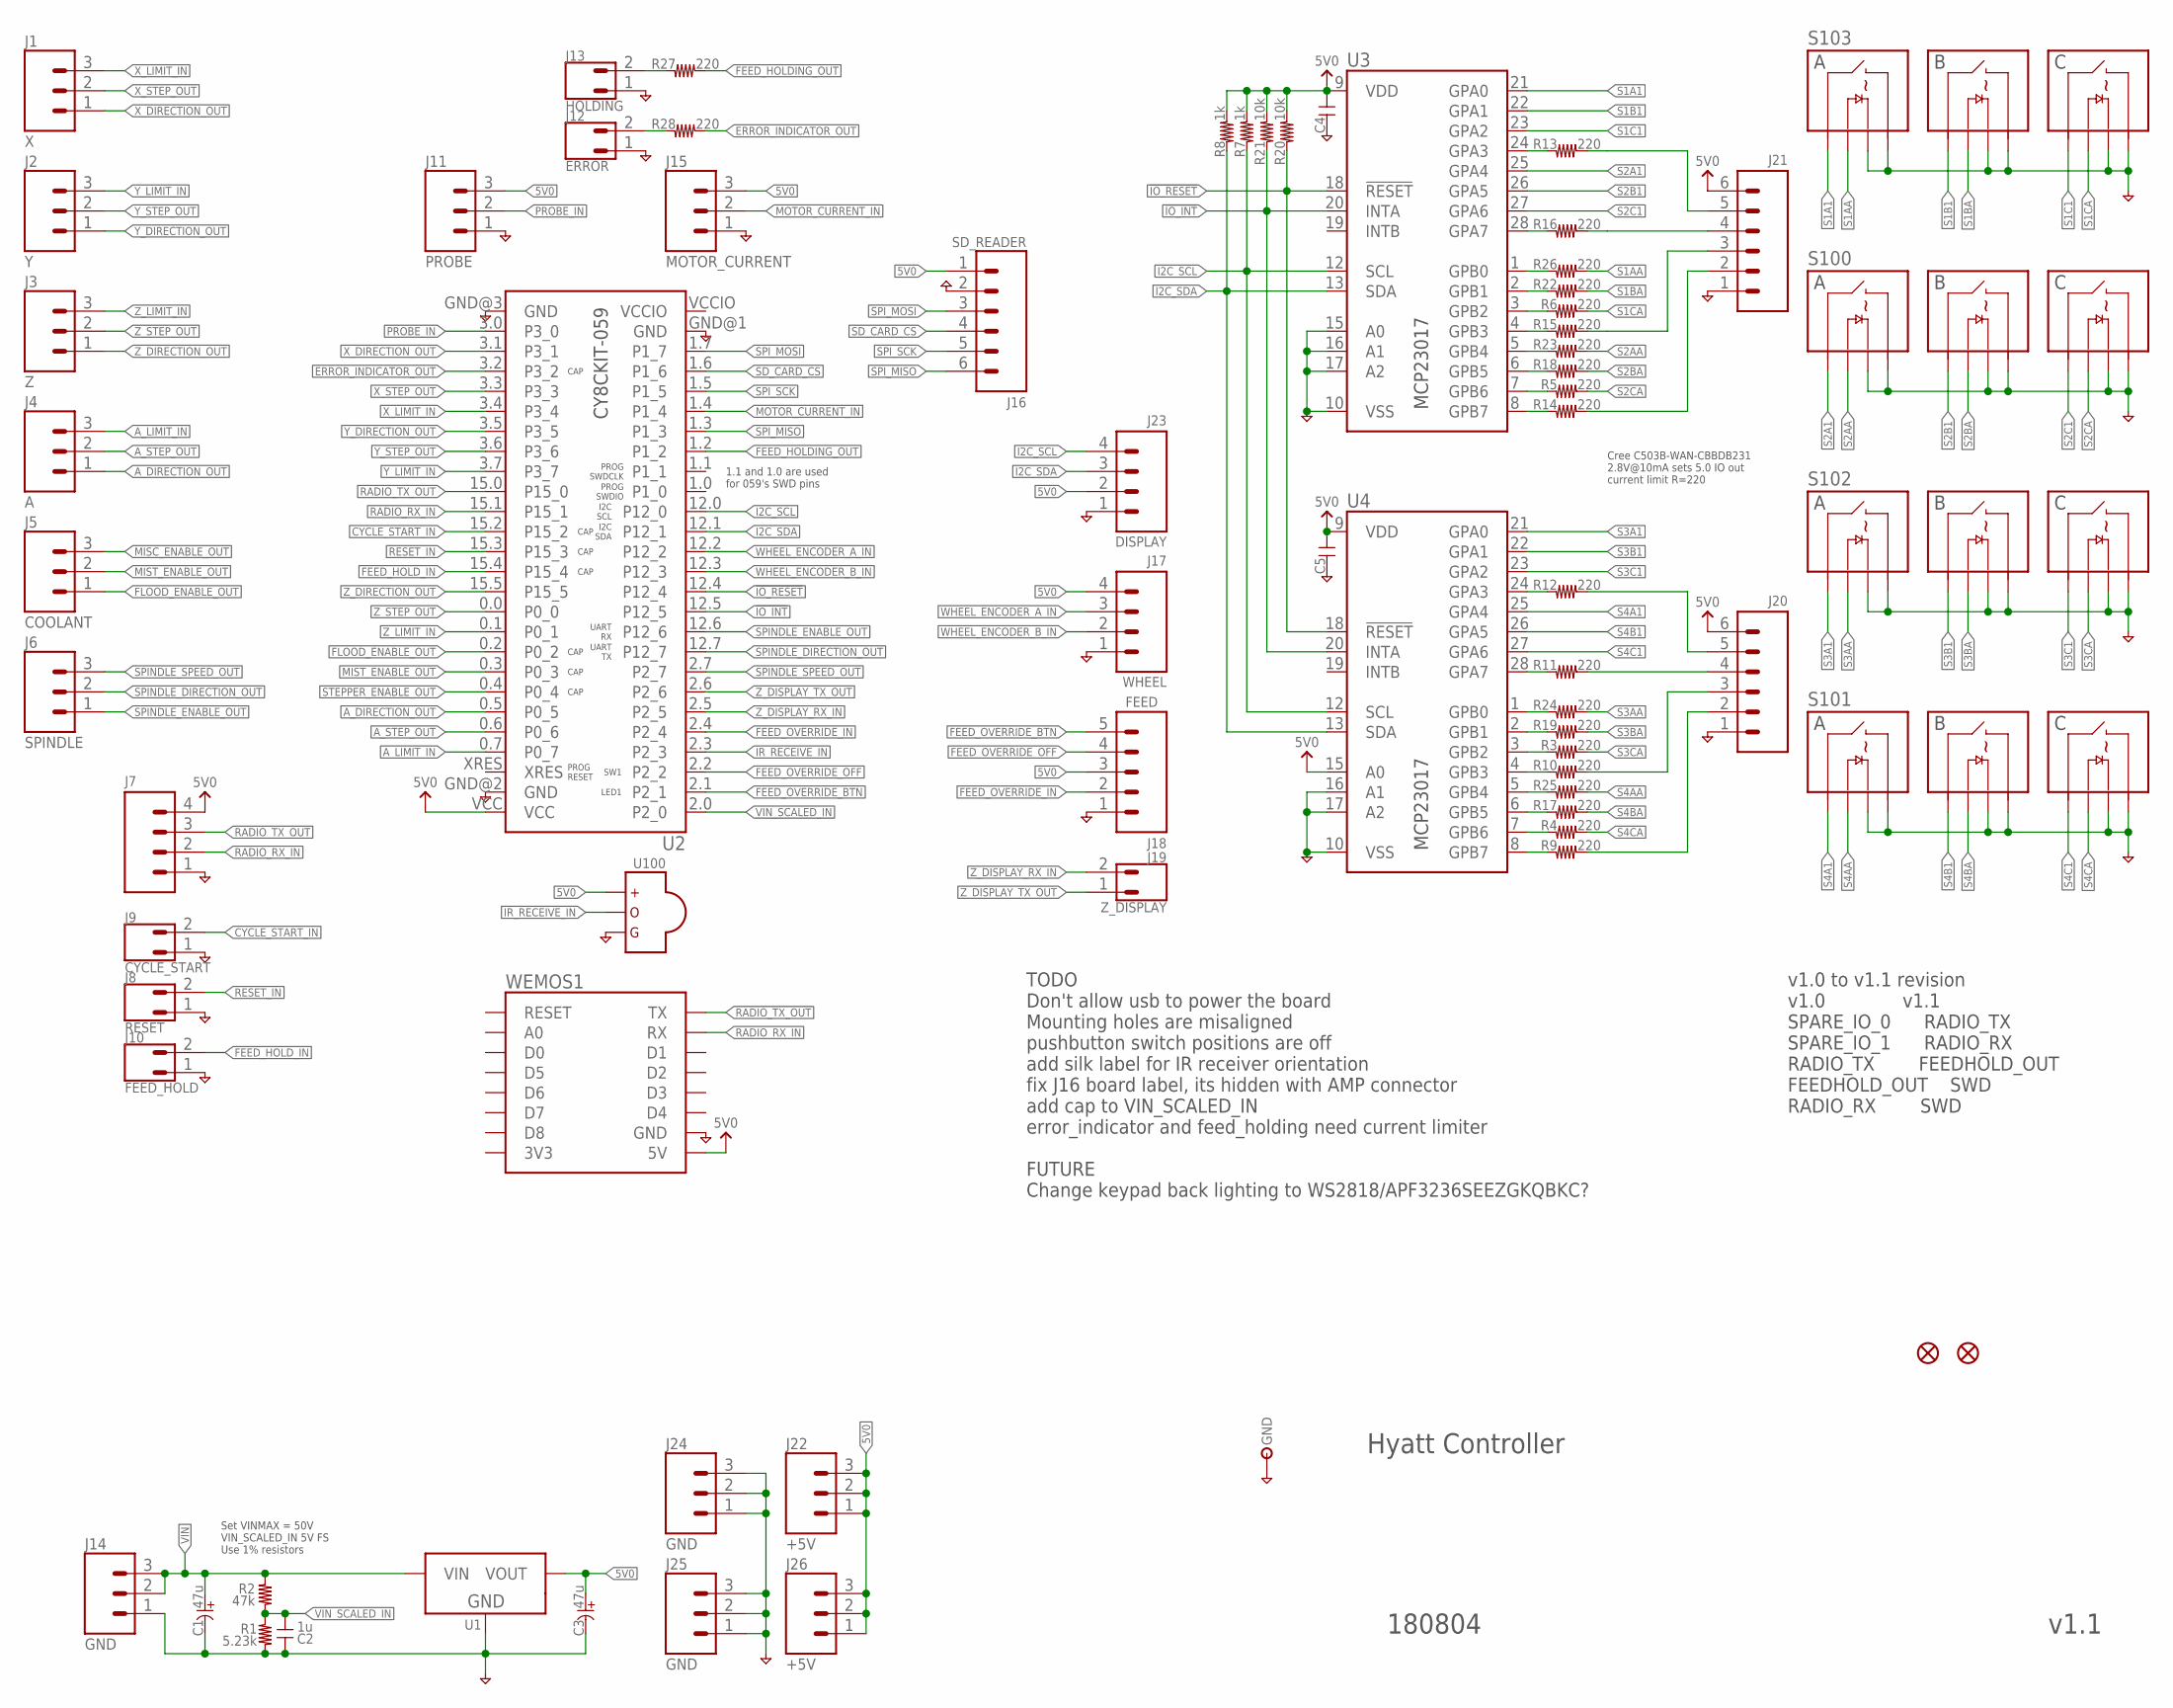
[picture p31: schematic controller.sch]

Parts:
C1, C3: 47u; E5-10
C2: 1u; C0603
C4, C5: C-0603; C0603
FID1, FID2: FIDUCIAL1.5X3; FIDUCIAL-1.5X3
GND: TESTPOINTTHRU; TPTHRU
J1: X; CONN-3.81MM-KF2EDG-3
J2: Y; CONN-3.81MM-KF2EDG-3
J3: Z; CONN-3.81MM-KF2EDG-3
J4: A; CONN-3.81MM-KF2EDG-3
J5: COOLANT; CONN-3.81MM-KF2EDG-3
J6: SPINDLE; CONN-3.81MM-KF2EDG-3
J7: CONN-04-0.1; 1X04
J8: RESET; CONN-.100-2
J9: CYCLE_START; CONN-.100-2
J10: FEED_HOLD; CONN-.100-2
J11: PROBE; CONN-3.81MM-KF2EDG-3
J12: ERROR; CONN-.100-2
J13: HOLDING; CONN-.100-2
J14, J24, J25: GND; CONN-3.81MM-KF2EDG-3
J15: MOTOR_CURRENT; CONN-3.81MM-KF2EDG-3
J16: SD_READER; 1X06
J17: WHEEL; CONN-.100-4
J18: FEED; 1X05
J19: Z_DISPLAY; CONN-3.81MM-KF2EDG-2
J20, J21: CONN-06-.100-VERT-HEADER; CONN-.100-6
J22, J26: +5V; CONN-3.81MM-KF2EDG-3
J23: DISPLAY; CONN-.100-4
R1: 5.23k; R0603
R2: 47k; R0603
R3, R4, R5, R6, R9, R10, R11, R12, R13, R14, R15, R16, R17, R18, R19, R22, R23, R24, R25, R26, R27, R28: 220; R0603
R7, R8: 1k; R0603
R20, R21: 10k; R0603
S100, S101, S102, S103: SWITCH-DTMF-3-LED
U1: VREG-SIP3
U2: BOARD-PSOC-CY8CKIT-059
U3, U4: MCP23017; SO28W
U100: SENSOR-IR-THRU; IRDETECTOR-THRU
WEMOS1: RADIO-WEMOS-D1-MINI; WEMOS-D1-MINI

Connections:
5V0: C3.+, C4.1, C5.1, J7.4, J11.3, J15.3, J16.1, J17.4, J18.3, J20.6, J21.6, J22.1, J22.2, J22.3, J23.2, J26.1, J26.2, J26.3, R7.2, R8.2, R20.2, R21.2, U1.3 (VOUT), U2.VCC, U3.9 (VDD), U4.9 (VDD), U4.15 (A0), U100.VCC, WEMOS1.5V
!IO_INT: R21.1, U2.12.5 (P12_5), U3.20 (INTA), U4.20 (INTA)
!IO_RESET: R20.1, U2.12.4 (P12_4), U3.18 (!RESET), U4.18 (!RESET)
A_DIRECTION_OUT: J4.1, U2.0.5 (P0_5)
A_LIMIT_IN: J4.3, U2.0.7 (P0_7)
A_STEP_OUT: J4.2, U2.0.6 (P0_6)
CYCLE_START_IN: J9.2, U2.15.2 (P15_2)
ERROR_INDICATOR_OUT: R28.2, U2.3.2 (P3_2)
FEED_HOLDING_OUT: R27.2, U2.1.2 (P1_2)
FEED_HOLD_IN: J10.2, U2.15.4 (P15_4)
FEED_OVERRIDE_BTN: J18.5, U2.2.1 (P2_1)
FEED_OVERRIDE_IN: J18.2, U2.2.4 (P2_4)
FEED_OVERRIDE_OFF: J18.4, U2.2.2 (P2_2)
FLOOD_ENABLE_OUT: J5.1, U2.0.2 (P0_2)
GND: C1.-, C2.2, C3.-, C4.2, C5.2, GND.1, J7.1, J8.1, J9.1, J10.1, J11.1, J12.1, J13.1, J14.1, J15.1, J16.2, J17.1, J18.1, J20.1, J21.1, J23.1, J24.1, J24.2, J24.3, J25.1, J25.2, J25.3, R1.1, S100.A_2, S100.A_C, S100.B_2, S100.B_C, S100.C_2, S100.C_C, S101.A_2, S101.A_C, S101.B_2, S101.B_C, S101.C_2, S101.C_C, S102.A_2, S102.A_C, S102.B_2, S102.B_C, S102.C_2, S102.C_C, S103.A_2, S103.A_C, S103.B_2, S103.B_C, S103.C_2, S103.C_C, U1.2 (GND), U2.GND@1 (GND), U2.GND@2 (GND), U2.GND@3 (GND), U3.10 (VSS), U3.15 (A0), U3.16 (A1), U3.17 (A2), U4.10 (VSS), U4.16 (A1), U4.17 (A2), U100.GND, WEMOS1.GND
I2C_SCL: J23.4, R7.1, U2.12.0 (P12_0), U3.12 (SCL), U4.12 (SCL)
I2C_SDA: J23.3, R8.1, U2.12.1 (P12_1), U3.13 (SDA), U4.13 (SDA)
IR_RECEIVE_IN: U2.2.3 (P2_3), U100.VOUT
MISC_ENABLE_OUT: J5.3
MIST_ENABLE_OUT: J5.2, U2.0.3 (P0_3)
MOTOR_CURRENT_IN: J15.2, U2.1.4 (P1_4)
unnamed: R26.1, U3.1 (GPB0)
unnamed: R22.1, U3.2 (GPB1)
unnamed: R13.1, U3.24 (GPA3)
unnamed: J21.5, R13.2
unnamed: R16.1, U3.28 (GPA7)
unnamed: J21.3, R15.2
unnamed: J21.4, R16.2
unnamed: R12.1, U4.24 (GPA3)
unnamed: R11.1, U4.28 (GPA7)
unnamed: J20.5, R12.2
unnamed: J20.4, R11.2
unnamed: J13.2, R27.1
unnamed: J12.2, R28.1
unnamed: R6.1, U3.3 (GPB2)
unnamed: R15.1, U3.4 (GPB3)
unnamed: R23.1, U3.5 (GPB4)
unnamed: R18.1, U3.6 (GPB5)
unnamed: R5.1, U3.7 (GPB6)
unnamed: R14.1, U3.8 (GPB7)
unnamed: R24.1, U4.1 (GPB0)
unnamed: R19.1, U4.2 (GPB1)
unnamed: R3.1, U4.3 (GPB2)
unnamed: R10.1, U4.4 (GPB3)
unnamed: R25.1, U4.5 (GPB4)
unnamed: R17.1, U4.6 (GPB5)
unnamed: R4.1, U4.7 (GPB6)
unnamed: R9.1, U4.8 (GPB7)
unnamed: J21.2, R14.2
unnamed: J20.3, R10.2
unnamed: J20.2, R9.2
PROBE_IN: J11.2, U2.3.0 (P3_0)
RADIO_RX_IN: J7.2, U2.15.1 (P15_1), WEMOS1.RX
RADIO_TX_OUT: J7.3, U2.15.0 (P15_0), WEMOS1.TX
RESET_IN: J8.2, U2.15.3 (P15_3)
S1A1: S103.A_1, U3.21 (GPA0)
S1AA: R26.2, S103.A_A
S1B1: S103.B_1, U3.22 (GPA1)
S1BA: R22.2, S103.B_A
S1C1: S103.C_1, U3.23 (GPA2)
S1CA: R6.2, S103.C_A
S2A1: S100.A_1, U3.25 (GPA4)
S2AA: R23.2, S100.A_A
S2B1: S100.B_1, U3.26 (GPA5)
S2BA: R18.2, S100.B_A
S2C1: S100.C_1, U3.27 (GPA6)
S2CA: R5.2, S100.C_A
S3A1: S102.A_1, U4.21 (GPA0)
S3AA: R24.2, S102.A_A
S3B1: S102.B_1, U4.22 (GPA1)
S3BA: R19.2, S102.B_A
S3C1: S102.C_1, U4.23 (GPA2)
S3CA: R3.2, S102.C_A
S4A1: S101.A_1, U4.25 (GPA4)
S4AA: R25.2, S101.A_A
S4B1: S101.B_1, U4.26 (GPA5)
S4BA: R17.2, S101.B_A
S4C1: S101.C_1, U4.27 (GPA6)
S4CA: R4.2, S101.C_A
SD_CARD_CS: J16.4, U2.1.6 (P1_6)
SPINDLE_DIRECTION_OUT: J6.2, U2.12.7 (P12_7)
SPINDLE_ENABLE_OUT: J6.1, U2.12.6 (P12_6)
SPINDLE_SPEED_OUT: J6.3, U2.2.7 (P2_7)
SPI_MISO: J16.6, U2.1.3 (P1_3)
SPI_MOSI: J16.3, U2.1.7 (P1_7)
SPI_SCK: J16.5, U2.1.5 (P1_5)
STEPPER_ENABLE_OUT: U2.0.4 (P0_4)
VIN: C1.+, J14.2, J14.3, R2.2, U1.1 (VIN)
VIN_SCALED_IN: C2.1, R1.2, R2.1, U2.2.0 (P2_0)
WHEEL_ENCODER_A_IN: J17.3, U2.12.2 (P12_2)
WHEEL_ENCODER_B_IN: J17.2, U2.12.3 (P12_3)
X_DIRECTION_OUT: J1.1, U2.3.1 (P3_1)
X_LIMIT_IN: J1.3, U2.3.4 (P3_4)
X_STEP_OUT: J1.2, U2.3.3 (P3_3)
Y_DIRECTION_OUT: J2.1, U2.3.5 (P3_5)
Y_LIMIT_IN: J2.3, U2.3.7 (P3_7)
Y_STEP_OUT: J2.2, U2.3.6 (P3_6)
Z_DIRECTION_OUT: J3.1, U2.15.5 (P15_5)
Z_DISPLAY_RX_IN: J19.2, U2.2.5 (P2_5)
Z_DISPLAY_TX_OUT: J19.1, U2.2.6 (P2_6)
Z_LIMIT_IN: J3.3, U2.0.1 (P0_1)
Z_STEP_OUT: J3.2, U2.0.0 (P0_0)

Notes on the sheet:
Hyatt Controller
180804
v1.1
TODO Don't allow usb to power the board Mounting holes are misaligned pushbutton switch positions are off add silk label for IR receiver orientation fix J16 board label, its hidden with AMP connector add cap to VIN_SCALED_IN error_indicator and feed_holding need current limiter FUTURE Change keypad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
Cree C503B-WAN-CBBDB231 2.8V@10mA sets 5.0 IO out current limit R=220
Set VINMAX = 50V VIN_SCALED_IN 5V FS Use 1% resistors
1.1 and 1.0 are used for 059's SWD pins
v1.0 to v1.1 revision v1.0 v1.1 SPARE_IO_0 RADIO_TX SPARE_IO_1 RADIO_RX RADIO_TX FEEDHOLD_OUT FEEDHOLD_OUT SWD RADIO_RX SWD

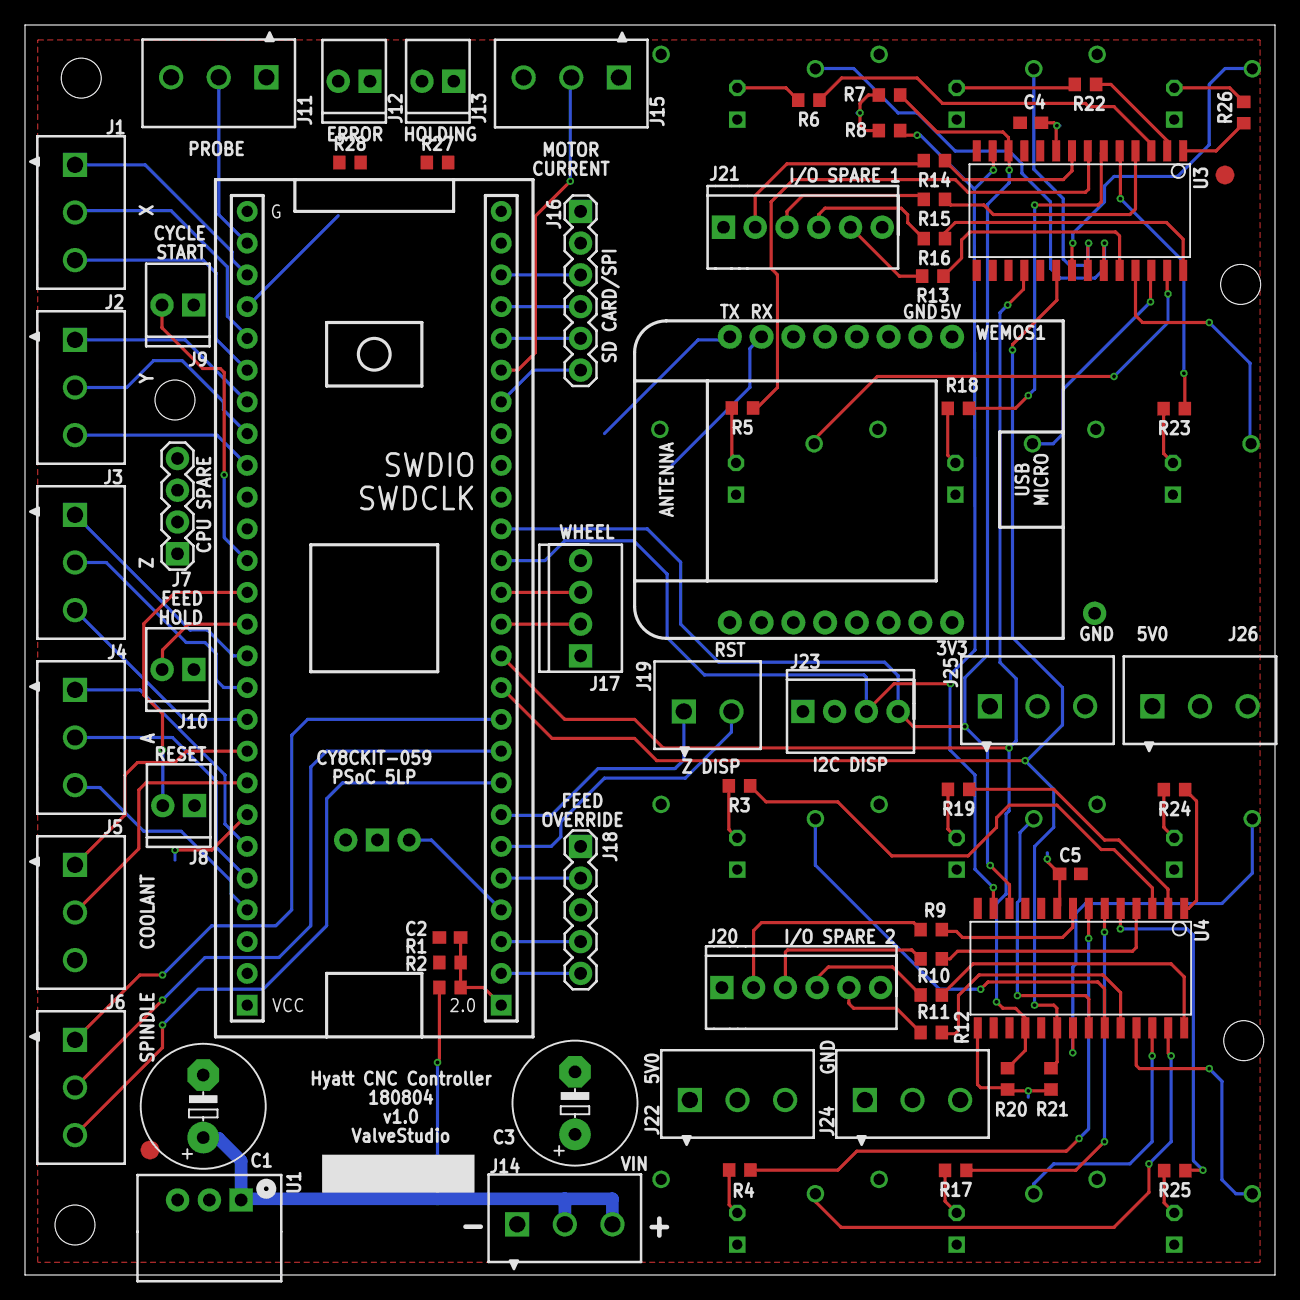
[picture p32: board controller.brd from above]

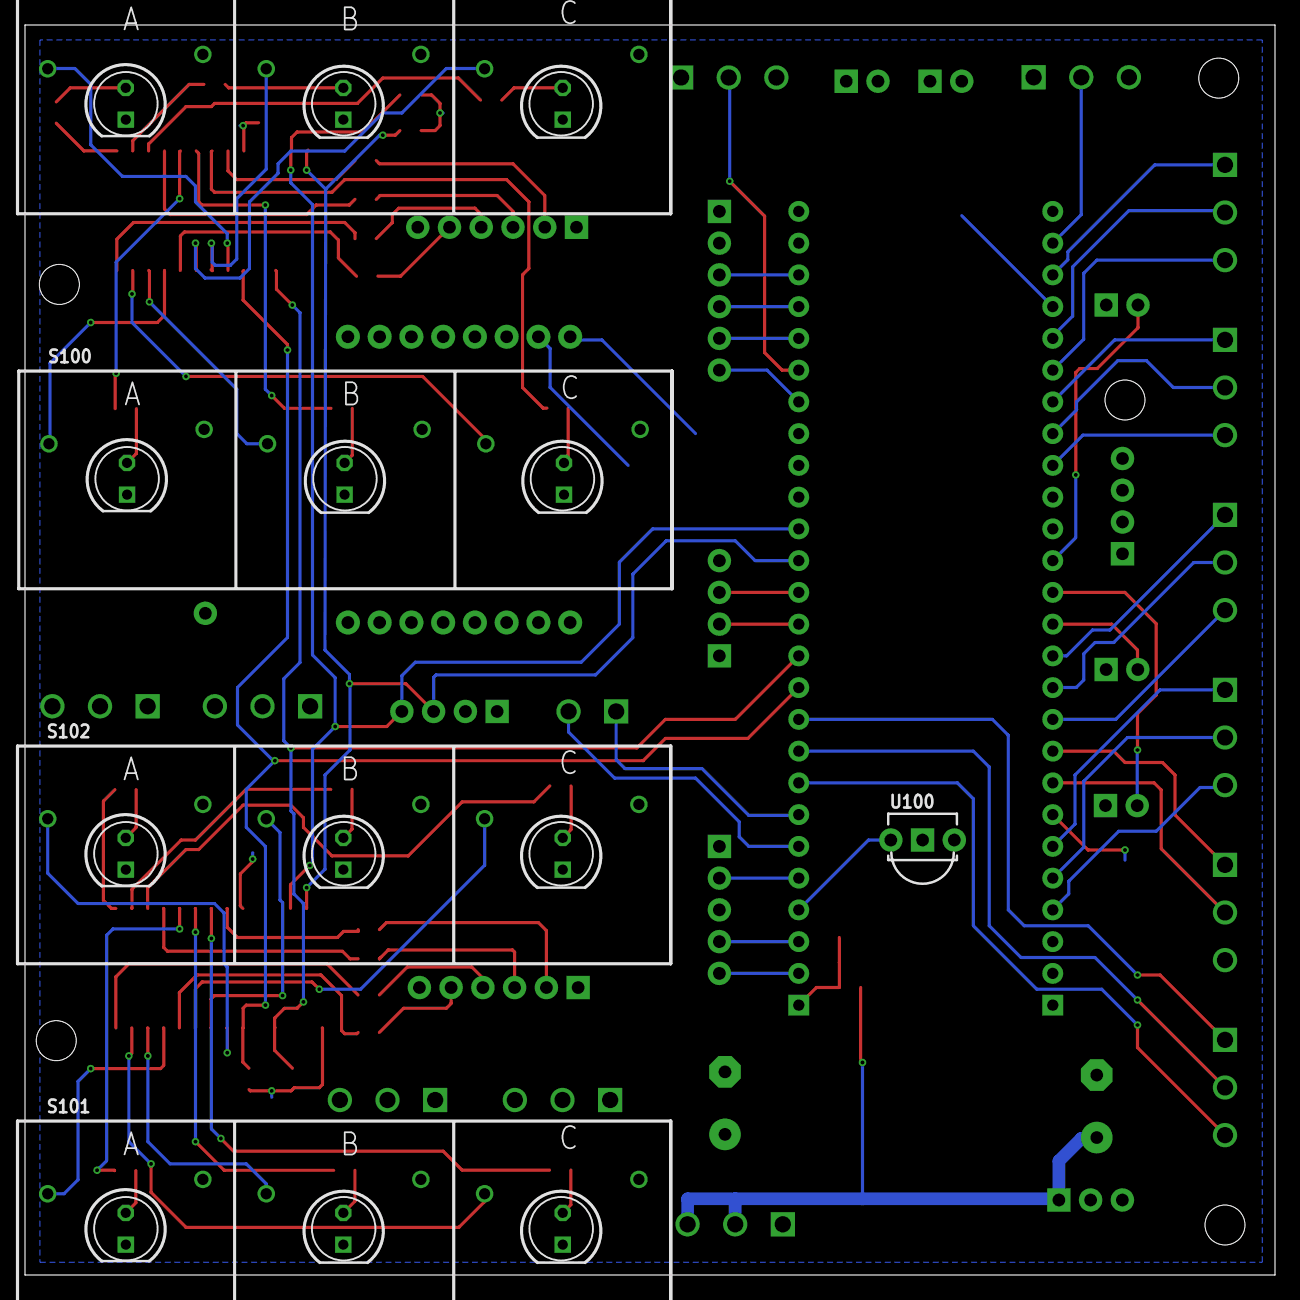
[picture p33: board controller.brd from below]

Board: 2 copper layers, 100.0 x 100.0 mm, 72 parts (5 on the bottom side), 100 nets.
