holla2040/hyatt/src/babysteps/nextion/nextion.cydsn/main.c

/* this project uses nextion display loaded with droSimple

    add m library gcc command line -lm
    change heap size to 0x200 in cydwr System
    add linker command line -u_printf_float
    
    https://nextion.itead.cc/resources/documents/instruction-set/

*/
#include "project.h"
#include <stdio.h>
#include <stdlib.h>
#include <math.h>
#include <stdbool.h>

char displayBuffer[50];
char consoleBuffer[50];
double t,x,y,z;
bool displayPending;

CY_ISR(updateHandler) {
    t += 0.01;
    displayPending = true;
    isrDisplay_ClearPending();
}

void displayUpdate() {
    char line[100];
    sprintf(line,"ref_stop\xff\xff\xffx.txt=\"%9.4f\"\xff\xff\xffy.txt=\"%9.4f\"\xff\xff\xffz.txt=\"%9.4f\"\xff\xff\xffref_star\xff\xff\xff",x,y,z);
    display_PutString(line);
    displayPending = false;

    LED_Write(!LED_Read());
}    
 
void lineProcess(char *line) {
    char c = line[0];
    int  i = atoi(&line[1]);

    display_PutString("line.txt=\"");
    display_PutString(line);
    display_PutString("\"\xff\xff\xff");
    
    if (c == 'G') {
        switch (i) {
            case 0:
                display_PutString("motion.txt=\"G0\"\xff\xff\xff");
                display_PutString("motionlabel.txt=\"rapid\"\xff\xff\xff");
                break;
            case 1:
                display_PutString("motion.txt=\"G1\"\xff\xff\xff");
                display_PutString("motionlabel.txt=\"linear\"\xff\xff\xff");
                break;
            case 20:
                display_PutString("unit.txt=\"G20\"\xff\xff\xff");
                display_PutString("unitlabel.txt=\"inch\"\xff\xff\xff");
                break;
            case 21:
                display_PutString("unit.txt=\"G21\"\xff\xff\xff");
                display_PutString("unitlabel.txt=\"mm\"\xff\xff\xff");
                break;
            case 90:
                display_PutString("distance.txt=\"G90\"\xff\xff\xff");
                display_PutString("distancelabel.txt=\"absolute\"\xff\xff\xff");
                break;
            case 91:
                display_PutString("distance.txt=\"G91\"\xff\xff\xff");
                display_PutString("distancelabel.txt=\"relative\"\xff\xff\xff");
                break;
            case 54:
            case 55:
            case 56:
            case 57:
            case 58:
                display_PutString("coordinate.txt=\"");
                display_PutString(line);
                display_PutString("\"\xff\xff\xff");
                break;
        }
    }               
    if (c == 'M') {
        switch (i) {
            case 3:
                display_PutString("spindle.txt=\"M3\"\xff\xff\xff");
                display_PutString("spindlelabel.txt=\"spin on\"\xff\xff\xff");
                break;
            case 5:
                display_PutString("spindle.txt=\"M5\"\xff\xff\xff");
                display_PutString("spindlelabel.txt=\"spin off\"\xff\xff\xff");
                break;
            case 7:
                display_PutString("coolant.txt=\"M7\"\xff\xff\xff");
                display_PutString("coolantlabel.txt=\"cool on\"\xff\xff\xff");
                break;
            case 9:
                display_PutString("coolant.txt=\"M9\"\xff\xff\xff");
                display_PutString("coolantlabel.txt=\"cool off\"\xff\xff\xff");
                break;
        }
    }
    if (c == 'I') {
        display_PutString("status.bco=2016\xff\xff\xff");
        display_PutString("status.txt=\"idle\"\xff\xff\xff");
    }
    if (c == 'H') {
        display_PutString("status.bco=65504\xff\xff\xff");
        display_PutString("status.txt=\"hold\"\xff\xff\xff");
    }
    if (c == 'R') {
        display_PutString("status.bco=32159\xff\xff\xff");
        display_PutString("status.txt=\"running\"\xff\xff\xff");
    }
    if (c == 'A') {
        display_PutString("status.bco=63488\xff\xff\xff");
        display_PutString("status.txt=\"alarm\"\xff\xff\xff");
    }
    if (c == 'O') {
        sprintf(line,"override.txt=\"%d%%\"\xff\xff\xff",i);
        display_PutString(line);
    }   
    if (c == 'F') {
        sprintf(line,"feed.txt=\"F%d\"\xff\xff\xff",i);
        display_PutString(line);
    }   
}
void displayProcessChar(uint8_t c) {
    if (c == '\n') {
        lineProcess(displayBuffer);
        strcpy(displayBuffer,"");
    } else {
        char tmpstr[2];
        tmpstr[0] = c;
        tmpstr[1] = 0;

        strcat(displayBuffer,tmpstr);
    }
    if (strlen(displayBuffer) > 48) {
        strcpy(displayBuffer,"");
    }
}
void consoleProcessChar(uint8_t c) {
    if (c == '\r') {
        lineProcess(consoleBuffer);
        strcpy(consoleBuffer,"");
    } else {
        char tmpstr[2];
        tmpstr[0] = c;
        tmpstr[1] = 0;

        strcat(consoleBuffer,tmpstr);
    }
    if (strlen(consoleBuffer) > 48) {
        strcpy(consoleBuffer,"");
    }
}

int main(void)
{
    uint8_t c;
    CyGlobalIntEnable;
    console_Start();
    display_Start();
//   clockDisplay_Start();
    isrDisplay_StartEx(updateHandler);
    
    console_PutString("\n\nnextion main\n");
    display_PutString("line.txt=\"nextion main\"\xff\xff\xff");
    display_PutString("status.txt=\"running\"\xff\xff\xff");

    for(;;)
    {
        if ((c = display_GetChar()) != 0) { 
            if ((c > 31 && c < 127) || c == '\r' || c == '\n') {  
                c = toupper(c);
                displayProcessChar(c);
                console_PutChar(c);
            }
        }
        if ((c = console_GetChar()) != 0) { 
            if ((c > 31 && c < 127) || c == '\r' || c == '\n') {        
                c = toupper(c);
                consoleProcessChar(c);
                console_PutChar(c);
            }
        }
        if (displayPending) displayUpdate();
        x = 500.0*cos(t)+500.0;
        y = 500.0*sin(t)+500.0;
        z = 50.0*sin(t+3.00)-50.0;
        
        while(SW_Read() == 0) {
            LED_Write(1);
        }
    }
}
