holla2040/hyatt/(commit log)

2018-07-31 initial add
    [controller.brd, controller.sch]
2018-08-03 started routing added datasheets
    [controller.brd, controller.sch]
2018-08-03 added datasheet continued routing
    [controller.brd, controller.sch]
2018-08-03 pin assignment and routing near completion
    [controller.brd, controller.sch]
2018-08-03 fixed 5V0/GND islands
    [controller.brd, controller.sch]
2018-08-04 corrected keyboard switch dimensions
    [controller.brd, controller.sch]
2018-08-04 initial add of files
    [RT0700 Halter v9.step, RT0700 im Halter v1.step, RT0700 v10.step]
2018-08-05 finished routing, almost ready to send
    [controller.brd, controller.sch]
2018-08-06 re-organizing pin layout due to creator optimization
    [controller.brd, controller.sch]
2018-08-06 reworked connector positions and pin mapping
    [controller.brd, controller.sch]
2018-08-06 corrected wemos silkscreen
    [controller.brd, controller.sch]
2018-08-06 fixed stepper_enable_out
    [controller.brd, controller.sch]
2018-08-06 release v1.0
    [controller.brd, controller.sch]
2018-08-07 initial add for board renders
2018-08-08 fixed a couple issues and added creator's temp build files to ignore
2018-08-08 added pin mapping
2018-08-17 updated wemos silk, added info to notes
    [controller.brd, controller.sch]
2018-08-21 blinks 1A LED
2018-08-22 grouped the wires
2018-08-22 added component values to schematic cleaned up brd layout
    [controller.brd, controller.sch]
2018-08-22 working on pushbutton interrupt
2018-08-24 now ignoring gerber files
2018-08-24 blinks both io expanders resets io expanders during initialization
    [main.c]
2018-08-25 updated schematic info initial add for rest
    [controller.sch]
2018-08-25 updated sch info added pushbutton datasheet
    [controller.sch]
2018-08-26 updated some device line widths
    [controller.sch]
2018-08-26 added serial reporting fixed binary counting to skip 0x08 'missing' bit u3 button indication now toggles per button press
    [main.c]
2018-08-26 uarts usb,wifi,display,kitprog all functional now
2018-08-26 a little cleaning in main.c started v1.1 of schematic, v1.0 boards need blue-wired
    [controller.brd, controller.sch]
2018-08-27 updated several net names in schematic and psoc changed I2C to fixed instead of UDB
    [controller.brd, controller.sch]
2018-08-31 updated a net name
    [controller.brd, controller.sch]
2018-09-03 worked on labeling, spinenable now enables spindle power
2018-09-03 release dir org extracted release sch/brd files
    exacted
    [controller.brd, controller.sch]
2018-09-04 added interrupt driven x,y, and z display updates
2018-09-05 changed 96 to 80 point laid out buttons added override, status and feed fields status has 4 background colors, green, blue, yellow, red for grbl state line field now editable, added enter button to s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
2018-09-15 added jog wheel calcs
2018-09-16 updated a couple items
2018-09-21 added spindle and air functionality now updating display during hold now reading usb during hold now sending init message on 'fake' usb dtr toggle to get ugs to 'see' reboot
2018-09-22 subbed in feedoverride now supports wheel operation added github gcode file
2018-09-22 feedoverride now functional
    [controller.sch]
2018-09-27 added actions array added spindle on/off to github.nc
2018-09-29 jog wheel improved doesn't override planning buffer sends jog commands out about 20 times faster, doesn't jump to run ~30mS after wheel stops turning, sends jog cancel
2018-10-04 added v1.0 to v1.1 notes
    [controller.sch]
2018-10-04 probe functional
2018-10-04 added more documentation
    [controller.brd, controller.sch]
2018-10-05 now routing spindle enable through estop, to keep AC out of controller box
2018-10-13 changed updated cad model
2018-10-28 good working start hard and soft limits enable homing functional display refresh i2c is the issue with jogging
2018-10-29 removed the lcd enable toggle delay increased LCD frame rate
2018-11-02 tweaking display and keypad i2c bus sharing
2018-11-02 still tweaking on i2c
2018-11-02 still hacking on i2c sharing issues
    [LCD.c, main.c]
2018-11-02 still hacking on i2c real machine, still hangs on the i2c restart for keypad reads
2018-11-03 still i2c hacking
2018-11-03 changing interrupt configuration to interrupt-on-pin change, see 3.5.5 and 3.6.5
2018-11-03 change to interrupt-on-pin change successful. shorteded the wheel not change count to come out of jog faster
2018-11-03 now working on sender, moving to planner available flow control
2018-11-03 sender uses now serial buffer count flow control, functional no longer using sender callback ir can cancel sender keypad holds off if display buffer is in progress
    [main.c]
2018-11-04 wheel now uses serial buffer avail for flow control x and y move at same time during homing
2018-11-22 added info on laser driver board
2018-11-25 changed to inches, removed flange opening, now for 23/64" flush inserts
2018-11-28 added md
    [hyatt bom.ods]
2018-11-28 added additional items
    [hyatt bom.ods]
2019-03-03 don't know what changes are
    [controller.brd, controller.sch]
2019-03-03 fixed the inversion problem with spindle keypad backlight
2019-03-03 working on spindle_enable_out
2019-03-03 tweaking spindle_enable_out code
2019-03-03 mist, flood and spindle control now functional
2019-03-06 added currect limit resistors for holding and error control panel leds added alarm string to control panel display if in alarm state, hitting any control panel key clears alarm without reseting
    [controller.brd, controller.sch]
2019-03-06 now calling hyattLoop during homing per axis
2019-03-06 added a fake initial z position to move off work piece after power cycle
2019-03-06 loading lastBlock in display init to message user about homing required
2019-03-07 updated remote button definitions, added some new items
    [Makita-Router-Mount-Adaptor.stl]
2019-03-07 now calling hyattLoop more times during homing
2019-03-11 hacking on sender flow control
2019-03-12 added define for insert hole nc
2019-03-17 added a note
    [controller.sch]
2019-03-18 key 2,3 is now the 'enter', not the coord select started working on G92 offset using laser crosshair got the config #33 and #34 config to save, recall and report
2019-03-18 added some notes fast wheel Z moves now slower
2019-04-14 now soft-reset will also calls hyattinit and will stop the sender
    [main.c]
2019-04-14 sch added a couple values so charm.ulp would place ICs
    makefile
    moved so vim's ctrl-m would make project
    src
    not using G92 anymore, just setting selected coordinate system using hyatt_zero_offset_x,y from grbl settings #33 and #34
    [controller.brd, controller.sch]
2019-06-09 added more model display to Z now z wheel can't select fast
2019-06-09 corrected cheatsheet, updated todo
    [HyattCheatSheet.ods]
2019-06-09 trying to fix wheel0 restore on single op select and sender holding reset
2019-06-09 added homing on reboot
    [main.c]
2019-06-09 file ops wheel0Select
2019-06-09 fixed wheel0Select zero issue g28 macro now goes up before xy move
2019-07-04 working on function calling and laser crossair offset
2019-07-04 fixed laser x0 y0 set
